d3s1gn0va/CapstonePy/01_Project_Context.md

# 01 Project Context

> 이전 3채널 시점의 맥락 기록이다. 최신 소스와 6축/BLE/눈 구성은 [CURRENT_SOURCE.md](CURRENT_SOURCE.md), 각도/운용 상태는 `docs/09_CURRENT_STATE.md`와 `docs/08_CALIBRATION_AND_SAFETY.md`를 우선한다.

## 1. 프로젝트 한 줄 요약

Raspberry Pi 4, Arduino Mega 2560, PCA9685, 서보모터를 사용해 아이와 자연스럽게 상호작용하는 가정용 로봇 경험을 전시용 워킹 프로토타입으로 구현하는 산업디자인 캡스톤디자인 프로젝트다.

## 2. 프로젝트 개요

* 프로젝트명 또는 임시 이름: Capstone Robot Project, capstone-robot-project
* 핵심 주제: 아이의 일상 속 자연스러운 상호작용을 유도하는 가정용 상호작용 로봇
* 해결하려는 문제: 아이의 사회적 의사소통 행동을 반복적으로 관찰할 수 있는 자연스러운 상호작용 경험이 필요함
* 목표: 1차 심사용 워킹 프로토타입을 안정적으로 전시/시연할 수 있게 만드는 것
* 대상 사용자 또는 대상 상황: 아이가 있는 가정 환경, 전시/심사 현장에서의 시연 상황
* 최종적으로 만들고자 하는 것: 버튼 입력을 받아 고개, 팔, 카메라 서보, 음성, LED가 정해진 시퀀스로 작동하는 로봇 프로토타입

## 3. 프로젝트가 시작된 배경

이 프로젝트는 산업디자인 캡스톤디자인 프로젝트로 시작되었다. 사용자가 정리한 핵심 맥락은 “아이의 일상 속 자연스러운 상호작용을 유도하고, 사회적 의사소통 행동을 반복적으로 관찰할 수 있는 가정용 상호작용 로봇 경험”이다.

초기에는 Raspberry Pi, Arduino Mega 2560, PCA9685를 사용하는 로봇 기준 저장소를 만들고, Raspberry Pi 코드와 Arduino 코드를 안전하게 원격 개발/배포할 수 있는 구조를 갖추는 것이 주요 과제였다. 이후 전시 버튼 시퀀스, 고개/팔 서보 각도 조정, 카메라 서보 추가, 전원 OFF 버튼, 카메라 동작 LED까지 기능이 확장되었다.

## 4. 현재까지 진행된 흐름

### 저장소 기준 구조 생성

* 당시 다룬 내용: Raspberry Pi 코드, Arduino 코드, scripts, systemd, docs 구조를 생성함
* 새롭게 정리된 점: 이 저장소를 “단일 기준 저장소”로 사용하기로 함
* 방향이 바뀌었다면 바뀐 이유: 없음
* 그 단계 이후 남은 과제: 실제 Raspberry Pi 코드와 Arduino 코드를 가져와 자리표시자 파일을 교체해야 했음

### Raspberry Pi 실제 코드 가져오기

* 당시 다룬 내용: Mac 프로젝트 폴더로 Raspberry Pi의 `~/robot_demo`를 `rsync`로 가져옴
* 새롭게 정리된 점: Python 파일, WAV 파일 2개, Arduino ino 파일, 배포/상태/로그 스크립트가 기준 저장소에 정리됨
* 방향이 바뀌었다면 바뀐 이유: 빈 자리표시자 파일에서 실제 작동 코드 중심으로 전환됨
* 그 단계 이후 남은 과제: Python 검사, 민감정보 제외, 원격 배포/Arduino 빌드 자동화가 필요했음

### 원격 개발 자동화 정리

* 당시 다룬 내용: `deploy_pi.sh`, `status_robot.sh`, `logs_robot.sh`, `build_arduino_remote.sh`, `flash_arduino_remote.sh` 등을 정리함
* 새롭게 정리된 점: Raspberry Pi SSH 주소는 `hyunwoo@192.168.0.39`, SSH 키는 `~/.ssh/robotpi_ed25519`를 사용함
* 방향이 바뀌었다면 바뀐 이유: 집에서 Mac으로 개발하고 Pi/Arduino에 원격 배포하는 구조가 필요했음
* 그 단계 이후 남은 과제: Arduino 업로드는 반드시 사용자가 `Arduino 업로드 승인`이라고 명시한 뒤 진행해야 함

### 전시 시퀀스 고개/팔 조정

* 당시 다룬 내용: 기본 고개 위치와 목표 각도, 팔 각도, 이동 시간을 여러 차례 조정함
* 새롭게 정리된 점: 현재 전시 버튼 시퀀스는 고개 `0 -> 70 -> 0`, 팔 `90 -> 180 -> 90` 흐름이며, 고개와 팔의 상승 이동은 동시에 시작함
* 방향이 바뀌었다면 바뀐 이유: 처음에는 고개가 먼저 다 돌아간 뒤 팔이 움직였지만, 사용자가 “고개 돌아갈때 팔도 같이 움직이게” 바꾸길 원했음
* 그 단계 이후 남은 과제: 팔 180도 사용은 기구물 충돌 가능성이 있으므로 실제 작동 시 계속 확인해야 함

### 카메라 서보 추가

* 당시 다룬 내용: PCA9685 Channel 2에 카메라 좌우 회전 서보를 추가함
* 새롭게 정리된 점: 카메라 버튼을 누르면 카메라 서보가 `90 -> 30 -> 150 -> 90`으로 움직임
* 방향이 바뀌었다면 바뀐 이유: 사용자가 “3번핀에 서보를 추가했는데, 이게 뭐냐면 카메라를 좌 우로 돌리는 서보모터”라고 설명함
* 그 단계 이후 남은 과제: 카메라 서보 모델명, 실제 장착 방향, 케이블 걸림 여부는 [확인 필요]

### 버튼 3개 구조 추가

* 당시 다룬 내용: 기존 전시 버튼 외에 전원 OFF 버튼, 카메라 움직임 버튼을 추가함
* 새롭게 정리된 점: 전시 버튼은 GPIO17, 전원 OFF 버튼은 GPIO27, 카메라 버튼은 GPIO22를 사용함
* 방향이 바뀌었다면 바뀐 이유: 사용자가 “스위치를 두개를 더 만들고싶어”라고 요청함
* 그 단계 이후 남은 과제: 전원 OFF 버튼은 sudoers 설정이 필요함. `scripts/setup_pi_shutdown_permission.sh`를 실행해야 함

### 카메라 LED 추가

* 당시 다룬 내용: 카메라 버튼을 눌러 카메라 서보가 회전하는 동안 3V 규격 LED 한 개를 켜는 기능을 추가함
* 새롭게 정리된 점: 카메라 LED는 Raspberry Pi GPIO23, 물리 핀 16번을 사용함
* 방향이 바뀌었다면 바뀐 이유: 사용자가 “카메라 버튼을 눌렀을때 카메라 서보가 회전하는 동안 약 3V전압 규격의 LED 한개를 켜져있게” 하고 싶다고 요청함
* 그 단계 이후 남은 과제: LED 배선에는 220Ω 또는 330Ω 직렬 저항이 필요함. 실제 밝기와 방향은 [확인 필요]

## 5. 현재 확정된 방향

* 문제정의: 아이가 자연스럽게 반응할 수 있는 로봇 상호작용을 만들고, 그 과정에서 사회적 의사소통 행동을 관찰할 수 있게 한다
* 타깃 사용자: 아이와 보호자가 있는 가정 환경, 그리고 1차 심사용 전시 상황
* 컨셉 방향: 버튼 입력 하나로 짧고 반복 가능한 상호작용 시퀀스를 수행하는 가정용 상호작용 로봇
* 핵심 기능 또는 구성:
  * 전시 버튼: 고개 회전, 팔 상승, WAV 음성 2개 재생, 초기 자세 복귀
  * 카메라 버튼: 카메라 서보 좌우 회전과 LED 점등
  * 전원 OFF 버튼: Raspberry Pi 안전 종료 요청
  * Raspberry Pi: 버튼 입력, 오디오 재생, 시퀀스 타임라인 제어
  * Arduino Mega: USB Serial 명령 수신, PCA9685를 통한 서보 제어
  * PCA9685: 고개, 오른팔, 카메라 서보 PWM 제어
* 발표/보고서에서 유지해야 할 논리: 기술 자체보다 “아이의 자연스러운 상호작용 경험”과 “반복 관찰 가능한 전시/가정용 프로토타입” 논리를 유지해야 함
* 제작 또는 구현 방향: Mac에서 코드 수정, Raspberry Pi로 rsync 배포, Arduino는 Pi에서 arduino-cli로 원격 컴파일/업로드

## 6. 현재 프로젝트 상태

* 이미 정리된 것:
  * 저장소 구조와 문서 구조
  * Raspberry Pi 실제 코드
  * Arduino Mega + PCA9685 펌웨어
  * WAV 파일 2개: `01_name_call.wav`, `02_lets_play.wav`
  * 원격 배포/상태/로그/Arduino 빌드/업로드 스크립트
  * 3버튼, 3서보, 카메라 LED 구조
* 아직 부족한 것:
  * 실제 로봇 외형, 기구 구조, 치수, 재료, 마감 정보
  * 실제 배선 사진과 전원 분배 구조
  * 카메라 서보 모델명과 장착 방향
  * 카메라 30..150도, 팔 180도 범위의 장기 안전성 확인
  * 전원 OFF 버튼 sudoers 설정 완료 여부 [확인 필요]
  * 전시 자동 실행 방식의 현장 검증 결과 [확인 필요]
* 현재 가장 중요한 문제:
  * 넓어진 서보 범위에서 기구물 충돌, 케이블 걸림, 전원 부족 문제가 없는지 실제 장치에서 확인해야 함
* 다음에 바로 해야 할 일:
  * 카메라 LED를 GPIO23에 저항 포함 배선
  * 카메라 버튼을 눌러 LED ON/OFF와 카메라 서보 동작 확인
  * 전시 버튼을 눌러 고개/팔 동시 이동과 WAV 재생 확인
  * 전원 OFF 버튼이 실제로 Pi를 안전 종료하는지 확인

## 7. 다른 GPT가 이어받을 때 꼭 알아야 할 것

* 사용자는 이 저장소를 “단일 기준 저장소”로 쓰고 싶어 한다.
* 사용자가 중요하게 말한 버튼 이름은 “전시버튼”, “카메라 버튼”, “전원off 버튼”이다.
* Arduino 업로드는 반드시 사용자가 `Arduino 업로드 승인`이라고 명시해야 진행한다.
* `SERVO_MIN_PULSE_US = 1000`, `SERVO_MAX_PULSE_US = 2000`은 별도 승인 없이 바꾸면 안 된다.
* 현재 서보 범위는 넓다. 팔 180도, 카메라 30..150도는 충돌/케이블 걸림 위험이 있다.
* Raspberry Pi 프로그램 시작 시 기본 자세 이동 명령이 나간다. 현재 부팅/시작 시 고개 `0도`, 팔 `90도`로 `1800ms` 이동한다.
* Arduino는 실제 서보 위치를 센서로 읽지 않는다. 부팅 직후 내부 현재값은 실제 물리 위치와 다를 수 있다.
* 오디오는 `pw-play`를 우선 사용한다.
* 공개 저장소에 SSH 키, 비밀번호, 토큰, `.env`, `scripts/local.env`, 로그 파일을 포함하면 안 된다.
* 실제 Raspberry Pi 상태와 저장소 문서 상태가 어긋날 수 있다. 작업 전 `config.py`, `main.py`, `servo_controller.ino`, 최근 로그를 확인하는 것이 좋다.

## 8. 다음 작업 제안

1. 카메라 LED 배선 후 카메라 버튼 테스트
   * GPIO23, 물리 핀 16번
   * GPIO23 -> 220Ω 또는 330Ω 저항 -> LED 긴 다리 -> LED 짧은 다리 -> GND
2. 팔 180도와 카메라 30..150도 범위의 물리 간섭 확인
   * 서보 혼, 외장, 케이블, 전원 공급 상태를 함께 확인
3. 전원 OFF 버튼 sudoers 설정 확인
   * `bash scripts/setup_pi_shutdown_permission.sh`
   * 성공 메시지: `Installed /etc/sudoers.d/010-robot-shutdown`
4. 전시 버튼 전체 시퀀스 확인
   * 고개/팔 동시 시작
   * `01_name_call.wav`, `02_lets_play.wav` 재생
   * 복귀 동작 확인
5. 배선 사진과 실제 핀맵을 `docs/assets/wiring/`에 추가
6. 로봇 외형/기구 구조 자료를 `docs/assets/robot_design/` 또는 `docs/assets/cad_exports/`에 추가
7. 문서 상태 갱신
   * `docs/09_CURRENT_STATE.md`가 실제 배포/업로드 상태와 맞는지 확인 필요
