d3s1gn0va/CapstonePy/02_Reasoning_and_Questions.md

# 02 Reasoning And Questions

> 이전 3채널 시점의 판단 기록이다. 최신 위임/범위/안전 기준은 `AGENTS.md`, `CURRENT_SOURCE.md`, `docs/09_CURRENT_STATE.md`를 우선한다.

## 1. 핵심 판단 흐름 요약

이 프로젝트는 처음에는 Raspberry Pi 4, Arduino Mega 2560, PCA9685를 사용하는 캡스톤디자인 로봇 프로젝트의 기준 저장소를 만드는 일에서 시작했다. 이후 Raspberry Pi 실제 코드와 Arduino 코드를 Mac 프로젝트로 가져오고, 원격 배포/컴파일/업로드 자동화 구조를 갖췄다.

기능은 처음의 “전시버튼을 누르면 고개와 팔, WAV 음성이 순서대로 실행되는 시퀀스”에서 출발했다. 이후 사용자가 고개 기본 각도와 목표 각도를 바꾸고, 서보 속도를 낮추고, 카메라 서보를 추가하고, 전원 OFF 버튼과 카메라 버튼을 추가하면서 3버튼/3서보 구조로 확장되었다.

현재 방향은 다음 판단에 의해 정리되었다.

* Raspberry Pi는 전체 타임라인과 버튼 입력, 오디오, LED를 담당한다.
* Arduino Mega는 PCA9685를 통해 서보만 안전 범위 안에서 움직인다.
* Arduino 업로드는 실제 하드웨어에 영향을 주므로 사용자가 `Arduino 업로드 승인`이라고 명시한 경우에만 진행한다.
* 전시 시퀀스는 사용자가 원하는 감각에 맞춰 고개와 팔이 동시에 움직이도록 바뀌었다.
* 카메라 버튼은 다른 서보와 음성을 건드리지 않고 카메라 서보와 LED만 제어하는 독립 기능으로 정리되었다.

## 2. 주요 의견과 관점

### 기준 저장소가 필요하다

* 내용: 이 폴더를 Raspberry Pi, Arduino Mega 2560, PCA9685를 사용하는 로봇 프로젝트의 기준 저장소로 만들고자 했다.
* 왜 중요했는지: 새 GPT 대화를 시작해도 프로젝트 맥락과 코드 위치, 안전 규칙을 잃지 않게 하기 위해서다.
* 프로젝트 방향에 준 영향: `AGENTS.md`, `README.md`, `docs/` 문서 구조, 원격 배포 스크립트, 안전 규칙이 만들어졌다.
* 사용자 원문이 있다면 원문: “이 폴더는 Raspberry Pi 4, Arduino Mega 2560, PCA9685를 사용하는 캡스톤디자인 로봇 프로젝트의 기준 저장소야.”

### GitHub 공개 저장소 안전이 중요하다

* 내용: SSH 개인키, 비밀번호, 토큰, `.env`, 로그 파일은 Git에 포함하지 않아야 한다.
* 왜 중요했는지: 저장소가 Public 상태로 유지될 예정이었기 때문이다.
* 프로젝트 방향에 준 영향: `.gitignore`가 보강되었고, 배포/업로드 작업 전 민감정보 검사가 반복되었다.
* 사용자 원문이 있다면 원문: “GitHub 저장소는 Public 상태로 유지할 예정이다.”

### 전시 기능과 개발 시험 기능은 구분해야 한다

* 내용: 고개 0도에서 180도 이동 같은 기능은 개발 시험 항목으로 취급되었고, 최종 전시 동작과 구분되었다.
* 왜 중요했는지: 큰 각도 이동은 기구물 충돌과 서보 과부하 위험이 있기 때문이다.
* 프로젝트 방향에 준 영향: 위험 기능에는 명시적 확인 옵션이나 사용자 승인이 필요하다는 원칙이 생겼다.
* 사용자 원문이 있다면 원문: “고개 0도에서 180도 이동 요청은 현재 개발 시험 항목이며 최종 전시 동작으로 확정된 것이 아니다.”

### 사용자는 실제 하드웨어 배선 설명도 필요했다

* 내용: GPIO 번호뿐 아니라 브레드보드와 푸쉬스위치를 어디에 꽂아야 하는지 설명이 필요했다.
* 왜 중요했는지: 사용자가 “잘 몰라서”라고 말했기 때문에, 코드 변경만으로는 작업이 완성되지 않았다.
* 프로젝트 방향에 준 영향: 버튼 3개, 서보 3개, LED 배선 문서가 만들어졌다.
* 사용자 원문이 있다면 원문: “핀을 어디에서 어디로 꽂아야하는지 전부 알려줘 내가 잘 몰라서. 브레드보드랑 푸쉬스위치 연결까지 다 설명해줘.”

### 전원 OFF 버튼은 편의 기능이지만 sudoers 설정이 필요하다

* 내용: 터미널에 접속해서 끄는 대신 푸쉬스위치 한 번으로 Raspberry Pi를 끄고 싶어 했다.
* 왜 중요했는지: 전시/철수 상황에서 터미널 없이 안전 종료할 수 있어야 하기 때문이다.
* 프로젝트 방향에 준 영향: GPIO27 전원 OFF 버튼, `sudo shutdown -h now`, `setup_pi_shutdown_permission.sh`가 추가되었다.
* 사용자 원문이 있다면 원문: “이 스위치를 누르면 라즈베리파이가 꺼질수 있게 하는거야. 원래는 터미널 들어가서 해야했는데 그냥 푸쉬 스위치 한번만 누르면 끌수있게 해줘.”

### 카메라 서보는 독립 동작이어야 한다

* 내용: 카메라 버튼을 눌렀을 때 다른 서보는 가만히 있고 카메라만 천천히 좌우로 움직이길 원했다.
* 왜 중요했는지: 카메라 동작은 전시 시퀀스와 별도의 관찰/표현 기능으로 분리되어야 했기 때문이다.
* 프로젝트 방향에 준 영향: PCA9685 Channel 2, `MOVE_CAMERA`, GPIO22 카메라 버튼, 카메라 LED가 추가되었다.
* 사용자 원문이 있다면 원문: “다른거는 가만히 있고 카메라만 천천히 좌우로 움직이게 해줘.”

## 3. 주요 의문점과 고민

### 전원 켜고 시작할 때 서보가 무조건 기본 각도로 이동하는가?

* 내용: 사용자는 “전원 켜고 시작할 때”가 실제로 부팅 시 기본 자세 이동을 의미하는지 물었다.
* 왜 중요했는지: 전원을 켜자마자 서보가 움직이는 것은 전시 안전과 사용자 경험에 영향을 준다.
* 당시 고려한 답변 또는 방향: 현재 방식은 프로그램 시작 시 `MOVE_BOTH,0,90,1800` 명령을 보내 기본 자세로 이동하는 것이다. Arduino는 실제 서보 위치를 읽지 못하므로, 이미 그 각도에 있더라도 내부 상태 기준으로 움직일 수 있다.
* 현재 상태:
  * 해결됨

### 부팅 시 초기 자세 이동을 안 하는 방식이 가능한가?

* 내용: 부팅 시 초기 자세 이동 안 하기가 “매번 부팅시의 위치를 0도로 설정”하는 의미인지 질문했다.
* 왜 중요했는지: 사용자는 전원 투입 직후 움직임 여부를 이해하고 선택해야 했다.
* 당시 고려한 답변 또는 방향: “초기 자세 이동 안 하기”는 실제 서보를 0도로 맞추는 것이 아니라, 부팅 직후 아무 이동 명령도 보내지 않는 것이다. 그러나 사용자는 현재 방식을 유지하기로 했다.
* 현재 상태:
  * 보류

### 전시 버튼에서 팔이 언제 움직여야 하는가?

* 내용: 초기에는 고개가 다 돌아간 뒤 팔이 움직였지만, 사용자는 고개가 돌아가기 시작할 때 팔도 같이 움직이길 원했다.
* 왜 중요했는지: 전시 시퀀스의 인상과 타이밍이 달라지는 핵심 연출 요소다.
* 당시 고려한 답변 또는 방향: 고개 1200ms, 팔 900ms처럼 서로 다른 시간으로 동시에 시작하려면 새 Arduino 명령이 필요하다고 판단했다. 이후 사용자가 “그냥 팔도 1200ms으로 해”라고 했고, 기존 `MOVE_BOTH` 명령을 유지하는 방향으로 정리되었다.
* 현재 상태:
  * 해결됨

### 카메라 버튼과 전원 OFF 버튼이 먹통인 이유는 무엇이었나?

* 내용: 사용자는 전시버튼 외에는 아예 먹통이라고 느꼈다.
* 왜 중요했는지: 새로 추가한 GPIO 배선, Python 이벤트 처리, Arduino 펌웨어 업로드 여부를 구분해야 했다.
* 당시 고려한 답변 또는 방향: GPIO 감시 결과 GPIO22와 GPIO27은 누를 때 `hi -> lo`로 정상 변화했다. 전원 OFF는 sudoers 권한 문제였고, 카메라는 Arduino에 `MOVE_CAMERA` 펌웨어 업로드가 필요했다.
* 현재 상태:
  * 부분 해결

### 카메라 동작 중 LED를 켤 수 있는가?

* 내용: 사용자는 카메라 서보가 움직이는 동안 약 3V 전압 규격 LED 한 개를 켜고 싶어 했다.
* 왜 중요했는지: 카메라 동작 상태를 물리적으로 보여주는 피드백 기능이다.
* 당시 고려한 답변 또는 방향: Arduino가 아니라 Raspberry Pi GPIO23으로 LED를 제어하는 것이 가장 단순하고 적절하다고 판단했다. `run_camera_sequence()` 전후로 LED ON/OFF를 넣었다.
* 현재 상태:
  * 해결됨

## 4. 의사결정과 근거

### Raspberry Pi와 Arduino 역할 분리

* 결정한 내용: Raspberry Pi는 버튼/오디오/타임라인/LED, Arduino는 서보 PWM 제어를 담당한다.
* 고려했던 선택지: Arduino에서 더 많은 타임라인을 처리하는 방식도 가능했지만, 현재 코드와 요구는 Raspberry Pi 중심 타임라인에 맞았다.
* 선택한 이유: WAV 재생과 버튼 시퀀스, 원격 개발은 Raspberry Pi에서 다루기 쉽다.
* 근거: `main.py`가 전체 시퀀스를 제어하고, `servo_controller.ino`는 Serial 명령을 받아 PCA9685로 서보를 움직인다.
* 남은 불확실성: 최종 전시 자동 실행 방식의 현장 검증 결과는 [확인 필요]

### Arduino 업로드는 명시 승인 후에만 진행

* 결정한 내용: 사용자가 `Arduino 업로드 승인`이라고 정확히 말한 경우에만 Arduino 업로드를 진행한다.
* 고려했던 선택지: 컴파일 후 자동 업로드, 또는 업로드 직전 일반 확인
* 선택한 이유: Arduino 업로드는 보드 리셋과 서보 움직임을 유발할 수 있다.
* 근거: `AGENTS.md` 안전 규칙과 대화 중 반복된 사용자 승인 절차
* 남은 불확실성: 없음

### 카메라 버튼은 독립 시퀀스로 처리

* 결정한 내용: 카메라 버튼은 고개/팔/오디오와 무관하게 카메라 서보만 `90 -> 30 -> 150 -> 90`으로 움직인다.
* 고려했던 선택지: 전시 시퀀스 안에 카메라 움직임을 포함하는 방식
* 선택한 이유: 사용자가 “다른거는 가만히 있고 카메라만”이라고 요청했다.
* 근거: `main.py`의 `run_camera_sequence()`와 `serial_controller.py`의 `move_camera()`
* 남은 불확실성: 카메라 서보 모델명, 실제 장착 방향, 케이블 간섭 여부는 [확인 필요]

### LED는 Arduino가 아니라 Raspberry Pi GPIO로 제어

* 결정한 내용: 카메라 LED는 GPIO23으로 연결하고 Python에서 켜고 끈다.
* 고려했던 선택지: Arduino/PCA9685 쪽에서 LED 제어
* 선택한 이유: 카메라 버튼과 카메라 시퀀스 타이밍을 Raspberry Pi가 이미 알고 있어 Python에서 처리하는 것이 단순하다.
* 근거: `gpiozero.LED`, `CAMERA_LED_GPIO = 23`, `finally`로 LED OFF 보장
* 남은 불확실성: LED 실제 배선 방향, 저항값, 밝기는 [확인 필요]

### 팔과 고개 동시 이동은 기존 `MOVE_BOTH` 사용

* 결정한 내용: 고개와 팔을 동시에 1200ms 동안 움직이게 하고, 별도 Arduino 명령은 만들지 않는다.
* 고려했던 선택지: 고개 1200ms, 팔 900ms를 위해 새 `MOVE_BOTH_TIMED` 명령 추가
* 선택한 이유: 사용자가 “그냥 팔도 1200ms으로 해”라고 방향을 바꿨다.
* 근거: 기존 `MOVE_BOTH,<head>,<arm>,<duration>` 명령으로 충분해짐
* 남은 불확실성: 팔 180도에서 기구물 충돌이 없는지 [확인 필요]

## 5. 방향이 바뀐 지점

### 고개 전체 범위 이동에서 더 작은 전시 각도로 변경

* 이전 방향: 고개 `0 -> 180 -> 0` 흐름을 사용한 이력이 있다.
* 바뀐 방향: 현재 전시 버튼은 고개 `0 -> 70 -> 0`이다.
* 바뀐 이유: 사용자가 전시 시퀀스의 회전량을 조정하고 싶어 했다.
* 이 변화가 프로젝트에 준 영향: 고개 전체 범위 테스트는 개발 시험 성격으로 남고, 전시 시퀀스는 더 제한된 각도 이동이 되었다.

### 팔 움직임 순서 변경

* 이전 방향: 고개가 먼저 돌아간 뒤 팔이 움직였다.
* 바뀐 방향: 고개와 팔이 동시에 움직인다.
* 바뀐 이유: 사용자가 “고개가 돌아가기 시작할때, 팔의 움직임도 동시에 시작”하길 원했다.
* 이 변화가 프로젝트에 준 영향: 전시 시퀀스의 첫 동작이 더 통합된 제스처가 되었고, `MOVE_BOTH` 명령이 핵심이 되었다.

### 카메라 기능 추가

* 이전 방향: 고개와 오른팔 2서보 중심 구조였다.
* 바뀐 방향: 고개, 오른팔, 카메라 3서보 구조가 되었다.
* 바뀐 이유: 사용자가 카메라를 좌우로 돌리는 새 서보를 추가했다.
* 이 변화가 프로젝트에 준 영향: Arduino 안전 범위, Serial 명령, Python 버튼 처리, 배선 문서가 모두 확장되었다.

### 카메라 LED 피드백 추가

* 이전 방향: 카메라 버튼은 서보만 움직였다.
* 바뀐 방향: 카메라 서보가 움직이는 동안 GPIO23 LED가 켜진다.
* 바뀐 이유: 사용자가 카메라 동작 중 LED가 켜져 있기를 원했다.
* 이 변화가 프로젝트에 준 영향: Raspberry Pi GPIO 출력이 추가되었고, LED 배선 안전 규칙이 추가되었다.

## 6. 폐기되었거나 보류된 아이디어

### `MOVE_BOTH_TIMED` 같은 새 Arduino 명령

* 내용: 고개 1200ms, 팔 900ms처럼 서로 다른 시간으로 동시에 시작하려면 새 Serial 명령을 추가하는 방향을 검토했다.
* 왜 고려했는지: 기존 `MOVE_BOTH`는 고개와 팔에 같은 duration만 줄 수 있기 때문이다.
* 왜 폐기 또는 보류했는지: 사용자가 팔도 1200ms로 맞추겠다고 해서 필요 없어졌다.
* 다시 검토할 가능성이 있는지: 나중에 고개와 팔의 동시 시작은 유지하되 서로 다른 이동 시간이 필요해지면 다시 검토 가능하다.

### 부팅 시 초기 자세 이동 안 하기

* 내용: 프로그램 시작 시 기본 자세 이동 명령을 보내지 않는 방식
* 왜 고려했는지: 부팅 직후 서보 움직임이 발생하는 것을 피할 수 있기 때문이다.
* 왜 폐기 또는 보류했는지: 사용자가 “지금 상태 그대로 놔둬. 지금이 1번인거 맞지?”라고 하며 현재 방식을 유지했다.
* 다시 검토할 가능성이 있는지: 전원 투입 직후 움직임이 전시 안전에 문제가 되면 다시 검토 가능하다.

### Arduino가 아니라 Raspberry Pi에서 카메라 서보 직접 제어

* 내용: 카메라 서보를 Raspberry Pi GPIO/PWM으로 직접 제어하는 방식
* 왜 고려했는지: [확인 필요] 실제 대화에서 명시적으로 깊게 검토되지는 않았다.
* 왜 폐기 또는 보류했는지: 현재 구조가 Arduino + PCA9685 서보 제어로 일관되어 있고, 카메라 서보도 PCA9685 Channel 2에 추가하는 것이 자연스러웠다.
* 다시 검토할 가능성이 있는지: 현재는 낮다.

## 7. 아직 열려 있는 질문

* 질문: 전원 OFF 버튼 sudoers 설정이 실제로 완료되었는가?
* 왜 중요한지: 설정이 안 되어 있으면 버튼 입력은 들어와도 `sudo: 암호가 필요합니다`로 종료가 실패한다.
* 해결하려면 필요한 것: Raspberry Pi에서 `scripts/setup_pi_shutdown_permission.sh` 실행 결과 확인
* 우선순위: 높음

* 질문: 팔 180도 동작이 실제 기구물에 안전한가?
* 왜 중요한지: 팔 서보가 큰 각도로 움직이며 외장이나 다른 부품에 부딪힐 수 있다.
* 해결하려면 필요한 것: 실제 로봇에서 느린 속도 테스트, 충돌/과부하 확인
* 우선순위: 높음

* 질문: 카메라 30..150도 범위에서 케이블이 걸리지 않는가?
* 왜 중요한지: 카메라 케이블이 고개, 팔, 외장 구조물에 걸릴 수 있다.
* 해결하려면 필요한 것: 실제 배선 상태에서 반복 테스트
* 우선순위: 높음

* 질문: 카메라 LED 배선이 올바른가?
* 왜 중요한지: 저항 없이 연결하면 LED나 Raspberry Pi GPIO가 손상될 수 있다.
* 해결하려면 필요한 것: 220Ω 또는 330Ω 직렬 저항, LED 방향 확인
* 우선순위: 높음

* 질문: 최종 전시 자동 실행 방식은 현장에서 검증되었는가?
* 왜 중요한지: 전시에서는 네트워크 없이 전원 투입 후 자동으로 버튼 대기 상태가 되어야 한다.
* 해결하려면 필요한 것: 실제 Raspberry Pi 부팅 테스트와 로그 확인
* 우선순위: 중간

* 질문: 로봇 외형과 기구 구조, 전원 분배 구조는 문서화되었는가?
* 왜 중요한지: 다른 사람이 하드웨어를 이해하고 재현하려면 사진과 핀맵이 필요하다.
* 해결하려면 필요한 것: 배선 사진, CAD/스케치, 전원 공급 정보
* 우선순위: 중간

## 8. 다른 GPT가 반복하지 말아야 할 것

* Arduino 업로드를 사용자 승인 없이 진행하자고 제안하지 말 것.
* `SERVO_MIN_PULSE_US`, `SERVO_MAX_PULSE_US`를 임의로 바꾸지 말 것.
* 카메라 LED를 저항 없이 GPIO에 직접 연결하라고 안내하지 말 것.
* “부팅 시 초기 자세 이동 안 하기”를 현재 요구로 오해하지 말 것. 사용자는 현재 부팅 시 기본 자세 이동 방식을 유지하기로 했다.
* 카메라 버튼을 전시 시퀀스와 섞어 설명하지 말 것. 현재 카메라 버튼은 독립 동작이다.
* GPIO 번호와 물리 핀 번호를 혼동하지 말 것. 현재 문서는 BCM 번호 기준으로 코드가 작성되어 있다.
* 공개 저장소에 SSH 키, 비밀번호, 토큰, `.env`, 로그 파일을 포함하지 말 것.

## 9. 다른 GPT에게 전달할 핵심 메모

* 이 프로젝트는 “예쁜 요약”보다 실제 이어받기 가능한 작업 맥락이 중요하다.
* 사용자는 실제 하드웨어를 만지면서 진행하고 있으므로, 코드 변경뿐 아니라 배선, 전원, 충돌 위험을 함께 설명해야 한다.
* Raspberry Pi 쪽 변경은 Python 검사 후 배포하고, 배포 후 상태와 로그를 확인한다.
* Arduino 쪽 변경은 컴파일까지만 자동으로 가능하고, 업로드는 `Arduino 업로드 승인`이 필요하다.
* 현재 전시 버튼 시퀀스는 고개 `0 -> 70 -> 0`, 팔 `90 -> 180 -> 90`, 고개/팔 상승 동시 시작이다.
* 현재 카메라 버튼 시퀀스는 카메라 `90 -> 30 -> 150 -> 90`이며, 동작 중 GPIO23 LED가 켜진다.
* 전원 OFF 버튼은 GPIO27이고, 실제 종료에는 sudoers 설정이 필요하다.
* 문서와 실제 Raspberry Pi 상태가 어긋날 수 있으므로, 중요한 작업 전에는 로컬 코드와 Pi의 배포 상태를 모두 확인하는 것이 좋다.
