d3s1gn0va/CapstonePy/03_Current_Output.md

# 03 Current Output

> 이전 3채널 시점의 산출물 기록이다. 현재 소스 목록과 6축/BLE/눈 구성은 [CURRENT_SOURCE.md](CURRENT_SOURCE.md)를 우선한다.

## 1. 현재까지 만들어진 산출물 요약

현재까지 작성되었거나 정리된 산출물은 다음과 같다.

* 프로젝트 기준 저장소 구조
* `README.md`, `AGENTS.md`, `PLANS.md`
* 프로젝트 맥락 문서: `docs/00_PROJECT_BRIEF.md`부터 `docs/12_BUTTON_AND_SERVO_WIRING.md`
* 인수인계 문서:
  * `01_Project_Context.md`
  * `02_Reasoning_and_Questions.md`
* Raspberry Pi 실행 코드:
  * `main.py`
  * `config.py`
  * `serial_controller.py`
  * `audio_player.py`
* Arduino Mega + PCA9685 펌웨어:
  * `arduino/servo_controller/servo_controller.ino`
* 원격 개발 스크립트:
  * Raspberry Pi 배포, 상태 확인, 로그 확인
  * Arduino 원격 컴파일/업로드
  * Raspberry Pi shutdown 권한 설정
* 전시 기능:
  * 전시 버튼 시퀀스
  * 카메라 버튼 시퀀스
  * 전원 OFF 버튼
  * 카메라 동작 중 LED 점등
* 배선 설명:
  * 버튼 3개
  * 서보 3개
  * GPIO23 카메라 LED

## 2. 현재 컨셉 설명

* 컨셉명: [확인 필요]
* 한 줄 설명: 아이의 일상 속 자연스러운 상호작용을 유도하고, 사회적 의사소통 행동을 반복적으로 관찰할 수 있는 가정용 상호작용 로봇 경험
* 자세한 설명: Raspberry Pi와 Arduino Mega, PCA9685, 서보모터를 활용해 버튼 입력에 반응하는 로봇 워킹 프로토타입이다. 전시 버튼을 누르면 고개와 팔이 움직이고 WAV 음성이 재생된다. 별도 카메라 버튼을 누르면 카메라 서보가 좌우로 움직이며 LED가 켜진다. 전원 OFF 버튼은 Raspberry Pi 안전 종료를 요청한다.
* 해결하려는 문제: 아이가 자연스럽게 반응할 수 있는 상호작용 상황을 만들고, 그 과정에서 사회적 의사소통 행동을 반복적으로 관찰할 수 있게 하는 것
* 대상 사용자: 아이와 보호자가 있는 가정 환경, 1차 심사용 전시 상황
* 핵심 가치: 자연스러운 상호작용, 반복 가능한 시연, 관찰 가능한 행동, 하드웨어 기반 워킹 프로토타입
* 차별점: 단순한 화면 기반 인터랙션이 아니라 고개, 팔, 카메라, 음성, LED가 함께 작동하는 물리 로봇 경험이라는 점

## 3. 문제정의 문장

### 현재 가장 유력한 문장

* 문장: 아이의 일상 속 자연스러운 상호작용을 유도하고, 사회적 의사소통 행동을 반복적으로 관찰할 수 있는 가정용 상호작용 로봇 경험을 제안한다.
* 출처 구분: 사용자 제공 맥락을 바탕으로 저장소 문서에 정리된 문장
* 사용 가능 여부: 사용 가능
* 수정 필요 여부: 발표용으로는 더 짧게 다듬을 수 있음

### 이전에 사용했던 문장

* 문장: 이 프로젝트는 아이의 일상 속 자연스러운 상호작용을 유도하고, 사회적 의사소통 행동을 반복적으로 관찰할 수 있는 가정용 상호작용 로봇 경험을 제안합니다.
* 출처 구분: GPT가 `README.md`에 정리한 문장
* 사용 가능 여부: 사용 가능
* 수정 필요 여부: 문체를 보고서체로 통일할지 확인 필요

* 문장: 로봇은 아이가 일상 속에서 자연스럽게 반응할 수 있는 짧은 상호작용 경험을 제공한다.
* 출처 구분: GPT가 `docs/01_PRODUCT_CONCEPT.md`에 정리한 문장
* 사용 가능 여부: 사용 가능
* 수정 필요 여부: 문제정의보다는 컨셉 설명에 더 적합함

### 수정이 필요한 문장

* 문장: 목표는 화려한 복잡 기능보다 반복 가능한 시연 흐름을 통해 사회적 의사소통 행동을 관찰할 수 있는 상황을 만드는 것이다.
* 출처 구분: GPT가 `docs/01_PRODUCT_CONCEPT.md`에 정리한 문장
* 사용 가능 여부: 사용 가능
* 수정 필요 여부: “화려한 복잡 기능보다”는 발표 문장으로는 다소 구어적일 수 있어 표현 다듬기 필요

### 폐기된 문장

* 문장: [확인 필요]
* 출처 구분: 현재 대화와 저장소 문서에서 명확히 폐기된 문제정의 문장은 확인되지 않음
* 사용 가능 여부: 확인 필요
* 수정 필요 여부: 확인 필요

## 4. 사용자 시나리오 또는 사용 흐름

### 전시 시연 흐름

출처 구분: GPT가 저장소 문서와 코드 기준으로 정리한 흐름

1. 전시자가 전원을 연결한다.
2. Raspberry Pi가 부팅된다.
3. 로봇 프로그램이 실행되고 버튼 입력을 기다린다.
4. 전시 버튼을 누른다.
5. 고개와 오른팔이 동시에 움직이기 시작한다.
6. `01_name_call.wav`가 재생된다.
7. `02_lets_play.wav`가 재생된다.
8. 짧게 유지한다.
9. 고개와 오른팔이 초기 자세로 복귀한다.
10. 다음 버튼 입력을 기다린다.

현재 코드 기준 전시 버튼 동작:

```text
고개: 0 -> 70 -> 0
팔: 90 -> 180 -> 90
고개/팔 상승 이동 시간: 1200ms
복귀 시간: 1800ms
```

### 카메라 버튼 흐름

출처 구분: GPT가 코드 기준으로 정리한 흐름

1. 카메라 버튼을 누른다.
2. GPIO23 LED가 켜진다.
3. 카메라 서보가 `90 -> 30 -> 150 -> 90`으로 이동한다.
4. 카메라 서보 동작이 끝나면 LED가 꺼진다.
5. 다음 버튼 입력을 기다린다.

### 전원 OFF 버튼 흐름

출처 구분: GPT가 코드 기준으로 정리한 흐름

1. 전원 OFF 버튼을 누른다.
2. Raspberry Pi에서 `sudo shutdown -h now`를 실행한다.
3. Raspberry Pi가 안전 종료된다.

주의: 이 흐름은 `scripts/setup_pi_shutdown_permission.sh`로 sudoers 설정이 완료되어야 정상 작동한다. 완료 여부는 [확인 필요].

## 5. 기능 또는 구성 요소

* 기능/요소: 전시 버튼
* 설명: GPIO17, 물리 핀 11번. 전시 시퀀스를 시작한다.
* 필요한 이유: 관람자 또는 전시자가 로봇 상호작용을 반복 실행하기 위해 필요하다.
* 현재 상태:
  * 확정

* 기능/요소: 전시 시퀀스
* 설명: 고개 `0 -> 70 -> 0`, 팔 `90 -> 180 -> 90`, WAV 파일 2개 재생, 초기 자세 복귀로 구성된다.
* 필요한 이유: 1차 심사용 워킹 프로토타입의 핵심 시연 흐름이다.
* 현재 상태:
  * 확정

* 기능/요소: 카메라 버튼
* 설명: GPIO22, 물리 핀 15번. 카메라 서보만 좌우로 움직인다.
* 필요한 이유: 카메라 움직임을 전시 시퀀스와 분리해 독립적으로 확인하기 위해 필요하다.
* 현재 상태:
  * 확정

* 기능/요소: 카메라 서보
* 설명: PCA9685 Channel 2. 현재 동작은 `90 -> 30 -> 150 -> 90`이다.
* 필요한 이유: 카메라를 좌우로 돌리는 물리 움직임을 만들기 위해 필요하다.
* 현재 상태:
  * 확정

* 기능/요소: 카메라 LED
* 설명: GPIO23, 물리 핀 16번. 카메라 서보가 움직이는 동안 켜진다.
* 필요한 이유: 카메라 동작 중임을 시각적으로 표시하기 위해 필요하다.
* 현재 상태:
  * 확정

* 기능/요소: 전원 OFF 버튼
* 설명: GPIO27, 물리 핀 13번. Raspberry Pi 안전 종료를 요청한다.
* 필요한 이유: 터미널 접속 없이 푸쉬스위치 한 번으로 Raspberry Pi를 끄기 위해 필요하다.
* 현재 상태:
  * 부분 확인 필요

* 기능/요소: Raspberry Pi
* 설명: 버튼 입력, WAV 재생, 전체 시퀀스 타임라인, GPIO23 LED 제어를 담당한다.
* 필요한 이유: 오디오와 로봇 시퀀스를 통합 제어하기 위해 필요하다.
* 현재 상태:
  * 확정

* 기능/요소: Arduino Mega 2560
* 설명: USB Serial 명령을 받아 PCA9685를 통해 서보를 움직인다.
* 필요한 이유: 서보 PWM 제어와 안전 범위 검사를 담당하기 위해 필요하다.
* 현재 상태:
  * 확정

* 기능/요소: PCA9685
* 설명: 고개, 오른팔, 카메라 서보를 제어하는 PWM 드라이버다.
* 필요한 이유: 여러 서보를 안정적으로 제어하기 위해 필요하다.
* 현재 상태:
  * 확정

* 기능/요소: WAV 음성
* 설명: `01_name_call.wav`, `02_lets_play.wav` 두 파일을 사용한다.
* 필요한 이유: 로봇이 아이에게 말을 거는 상호작용 경험을 만들기 위해 필요하다.
* 현재 상태:
  * 확정

* 기능/요소: 자동 실행
* 설명: 전원을 켜면 Raspberry Pi가 자동 부팅되고 프로그램이 실행되어 버튼 입력을 기다리는 구성이 목표다.
* 필요한 이유: 전시에서는 네트워크 없이 독립 작동해야 하기 때문이다.
* 현재 상태:
  * 확인 필요

## 6. 발표자료 또는 보고서 구성

현재 대화와 저장소 문서에서 확인되는 발표/보고서 흐름 초안은 다음 정도다.

1. 프로젝트 배경
   * 산업디자인 캡스톤디자인 프로젝트
   * 아이의 일상 속 자연스러운 상호작용
   * 사회적 의사소통 행동의 반복 관찰
2. 문제정의
   * 자연스럽게 반응할 수 있는 상호작용 상황의 필요
3. 컨셉
   * 가정용 상호작용 로봇 경험
   * 짧고 반복 가능한 물리 시연
4. 시스템 구성
   * Raspberry Pi
   * Arduino Mega 2560
   * PCA9685
   * 고개/팔/카메라 서보
   * WAV 음성
   * 버튼 3개와 LED
5. 전시 시연 흐름
   * 전원 연결
   * 자동 실행 및 버튼 대기
   * 전시 버튼 시퀀스
   * 카메라 버튼 시퀀스
   * 안전 종료
6. 현재 워킹 프로토타입 상태
   * 구현 완료 기능
   * 아직 확인 필요한 기구/배선/전원 요소
7. 다음 개발 과제
   * 실제 배선 사진과 핀맵
   * 기구 충돌 확인
   * 전시 자동 실행 검증
   * 외형/기구 자료 추가

주의: 발표자료의 시각 스타일, 슬라이드 수, 보고서 최종 목차는 [확인 필요].

## 7. 그대로 보존하면 좋은 문장

### 사용자 직접 표현

* 문장: “이 폴더는 Raspberry Pi 4, Arduino Mega 2560, PCA9685를 사용하는 캡스톤디자인 로봇 프로젝트의 기준 저장소야.”
* 사용 가능 위치: 개발 문서, 저장소 설명
* 왜 중요한지: 프로젝트의 기술 스택과 기준 저장소 성격을 명확히 말한다.
* 수정 필요 여부: 발표용보다는 개발 문서용으로 그대로 사용 가능

* 문장: “아이의 일상 속 자연스러운 상호작용을 유도하고, 사회적 의사소통 행동을 반복적으로 관찰할 수 있는 가정용 상호작용 로봇 경험을 제안한다.”
* 사용 가능 위치: 문제정의, 컨셉 설명, README, 발표 서두
* 왜 중요한지: 프로젝트의 핵심 목적을 가장 잘 담고 있다.
* 수정 필요 여부: 거의 없음. 발표 제목/카피로 쓰려면 더 짧게 다듬을 수 있음

* 문장: “전시에서는 네트워크 없이 독립 작동해야 한다.”
* 사용 가능 위치: 전시 요구사항, 시스템 설계 조건
* 왜 중요한지: 자동 실행과 로컬 하드웨어 제어가 필요한 이유를 설명한다.
* 수정 필요 여부: 없음

* 문장: “전원을 켜면 Raspberry Pi가 자동 부팅되고 프로그램이 실행되어 시연 버튼 입력을 기다려야 한다.”
* 사용 가능 위치: 전시 시나리오, 시스템 요구사항
* 왜 중요한지: 전시 운영 방식의 핵심 요구사항이다.
* 수정 필요 여부: 없음

* 문장: “시연 중 추가 버튼 입력은 무시한다.”
* 사용 가능 위치: 동작 규칙, UX 설명
* 왜 중요한지: 중복 입력으로 시퀀스가 꼬이지 않게 하는 기준이다.
* 수정 필요 여부: 없음

* 문장: “철수 시에는 Raspberry Pi 안전 종료 후 전체 전원을 끈다.”
* 사용 가능 위치: 운영 SOP, 안전 문서
* 왜 중요한지: 전원 OFF 버튼과 shutdown 기능의 필요를 설명한다.
* 수정 필요 여부: 없음

* 문장: “다른거는 가만히 있고 카메라만 천천히 좌우로 움직이게 해줘.”
* 사용 가능 위치: 기능 요구사항 원문 기록
* 왜 중요한지: 카메라 버튼이 전시 시퀀스와 독립이어야 한다는 사용자 의도를 직접 보여준다.
* 수정 필요 여부: 보고서 본문에는 다듬어 사용

* 문장: “고개 돌아갈때 팔도 같이 움직이게.”
* 사용 가능 위치: 전시 시퀀스 연출 의도 기록
* 왜 중요한지: 고개와 팔 동시 이동으로 방향이 바뀐 근거다.
* 수정 필요 여부: 보고서 본문에는 다듬어 사용

* 문장: “그냥 팔도 1200ms으로 해”
* 사용 가능 위치: 구현 판단 기록
* 왜 중요한지: 새 Arduino 명령을 만들지 않고 기존 `MOVE_BOTH`를 유지한 이유다.
* 수정 필요 여부: 보고서용으로는 사용하지 않고 작업 기록에 보존

### GPT 작성 초안/정리 문장

* 문장: “Raspberry Pi가 버튼 입력, WAV 음성 재생, 전체 시연 타임라인을 제어합니다.”
* 사용 가능 위치: 시스템 설명
* 왜 중요한지: Raspberry Pi 역할을 간결히 설명한다.
* 수정 필요 여부: 현재는 LED 제어도 포함하므로 “LED 제어”를 추가해 다듬는 것이 좋음

* 문장: “Arduino Mega는 USB Serial 명령을 받아 PCA9685를 통해 고개 SG92R 서보, 로봇 기준 오른팔 MG996R 서보, 카메라 좌우 회전 서보를 움직입니다.”
* 사용 가능 위치: 시스템 설명
* 왜 중요한지: Arduino와 PCA9685의 역할을 정확히 설명한다.
* 수정 필요 여부: 서보 모델명 중 카메라 서보 모델은 [확인 필요]

* 문장: “목표는 화려한 복잡 기능보다 반복 가능한 시연 흐름을 통해 사회적 의사소통 행동을 관찰할 수 있는 상황을 만드는 것이다.”
* 사용 가능 위치: 컨셉 방향 초안
* 왜 중요한지: 프로젝트가 복잡한 기능보다 반복 가능한 경험에 집중한다는 방향을 보여준다.
* 수정 필요 여부: 발표용으로는 표현 다듬기 필요

* 문장: “기술 자체보다 ‘아이의 자연스러운 상호작용 경험’과 ‘반복 관찰 가능한 전시/가정용 프로토타입’ 논리를 유지해야 함”
* 사용 가능 위치: 발표/보고서 작성 원칙
* 왜 중요한지: 기술 설명에 매몰되지 않도록 하는 기준이다.
* 수정 필요 여부: 없음

## 8. 아직 다듬어야 할 초안

* 컨셉명: [확인 필요]
* 대상 사용자군 정의의 발표용 문장: [확인 필요]
* 실제 음성 대사의 최종 문구와 녹음 출처: [확인 필요]
* 로봇의 감성 키워드와 외형 디자인 언어: [확인 필요]
* 로봇 외형, 기구 구조, 치수, 재료, 마감 설명: [확인 필요]
* 전시 부스의 전원 투입/철수 SOP: [확인 필요]
* 전시 자동 실행 방식의 최종 선택: systemd 방식인지 Desktop Autostart 방식인지 [확인 필요]
* 전원 OFF 버튼 sudoers 설정 완료 여부: [확인 필요]
* 카메라 LED 실제 밝기, 저항값, 배선 방향 검증: [확인 필요]
* 팔 180도, 카메라 30..150도 장기 안전성 확인: [확인 필요]

## 9. 다음에 만들어야 할 산출물

1. 실제 배선 사진 기반 핀맵 문서
   * 버튼 3개, GPIO23 LED, PCA9685 서보 채널, 전원/GND 공통 연결을 사진과 함께 정리
2. 전시 시연 SOP
   * 전원 연결, 자동 실행 확인, 전시 버튼 테스트, 카메라 버튼 테스트, 전원 OFF 버튼, 철수 절차
3. 발표자료용 컨셉 페이지
   * 문제정의, 컨셉 한 줄, 로봇 경험 설명, 대상 사용자 정리
4. 시스템 아키텍처 다이어그램
   * Raspberry Pi, Arduino Mega, PCA9685, 서보 3개, 버튼 3개, LED, WAV 출력 관계
5. 하드웨어 안전 체크리스트
   * 서보 범위, 케이블 걸림, 외부 5V 전원, 공통 GND, LED 저항, Arduino 업로드 전 승인
6. 현재 코드/배포 상태 업데이트 문서
   * `docs/09_CURRENT_STATE.md`를 실제 배포/업로드 상태와 맞게 갱신
7. 최종 보고서 목차 초안
   * 현재 문서에는 큰 흐름만 있고, 실제 보고서 구조는 아직 [확인 필요]
