d3s1gn0va/CapstonePy/PLANS.md

# PLANS.md

## 목적

이 문서는 다음 작업 후보를 한곳에 모아두기 위한 계획 노트다. 확정된 현재 상태는 `docs/09_CURRENT_STATE.md`를 우선한다.

## 단기 계획

2026-10-05 최신 후속 요청은 **iPhone 연결 없이 먼저 앱 코딩**이다. 인접 `KeepEye`에서 전시 체험 UI/앱 BLE 클라이언트/상태 검사를 먼저 구현하고, Pi의 대응 BLE 서비스·현장 안전 조건과 실제 iPhone 시험을 이어간다. 앱 계약은 `KeepEye/Docs/CUVO-Robot-Control.md`, 로봇의 실제 배포·시험 상태는 `docs/09_CURRENT_STATE.md`를 따른다. 이 변경은 기존 전시 재시작/자동 실행 활성화나 검증 잠금 해제를 허가하지 않는다.

아래 목록은 앱 작업 전 로봇 통합 계획이다. 최신 6축 기준/춤 결과는 [춤 구현](docs/20_DANCE_SESSION.md)을 우선한다.

* 완료: 기존 기본 프로그램을 유지한 별도 눈/음성/6축 통합 코드, 안전 프로필, 그룹 명령, 가상 검사와 Mega용 컴파일.
* 다음: CH1/CH3/CH4/CH5의 실제 축 방향, 초기 자세, 최소/최대와 인사/초대 각도 및 전원 검증.
* 이후: Pi와 펌웨어 설정 일치 -> 검사/프로그램 중지/포트 확인 후 필요한 펌웨어 업로드·검증 -> 사용자 요청한 배포/실물 시험 -> 자동 실행 전환. 2026-10-05 최신 위임에 따라 요청한 변경의 업로드에는 재승인을 묻지 않는다.
* 배선 완료를 각도/전원 검증 완료로 취급하지 않는다. 미확정 값은 임의의 90도나 과거 180도로 채우지 않는다.

아래는 이전 작업 후보이며 현재 최신 상태와 우선순위를 먼저 확인한다.

1. GitHub 인증 문제를 해결한 뒤 원격 저장소 push 재시도.
2. Raspberry Pi로 배포하기 전 `scripts/check_python.sh` 재실행.
3. 전시 자동 실행 방식이 실제 Raspberry Pi OS 환경에서 의도대로 동작하는지 확인.
4. 하드웨어 배선 사진 또는 회로도를 `docs/assets/wiring/`에 추가.
5. 로봇 외형, CAD, 기구 구조 이미지를 `docs/assets/robot_design/` 또는 `docs/assets/cad_exports/`에 추가.

## 개발 시험 항목

* 고개 0도에서 180도 이동은 개발 시험 항목이며 최종 전시 기능으로 확정되지 않았다.
* 전체 범위 테스트는 반드시 사용자의 명시적 승인 후 작은 위험 점검 절차와 함께 수행한다.

## 보류

* 요청하지 않은 Arduino Mega 업로드 및 반복 업로드. 요청한 변경에 필요한 업로드는 최신 위임과 안전 절차에 따라 진행할 수 있다.
* 서보 PWM 펄스 폭 변경.
* 서보 안전 범위 확대.
* 자동 실행 활성화 명령 실행.
