d3s1gn0va/CapstonePy/docs/09_CURRENT_STATE.md

# 09 Current State

## 2026-10-20 GitHub 소스 인수인계 기준

* 사용자 요청으로 Mac의 최신 앱/로봇 소스를 기존 KeepEye/CapstonePy 저장소에 반영할 기준을 정리했다. 양쪽 `CURRENT_SOURCE.md`와 공통 태그 `cuvo-baseline-2026-10-20`으로 소스 위치·프로토콜·현재 원점/춤·미리보기 전용 기능을 구분한다. 오래된 3채널 맥락 문서에는 최신 안내를 추가했다.
* 비밀키/실제 인증값/환경 파일/서명 자료/빌드 결과물은 제외한다. 앱 저장소는 비공개, 로봇 저장소는 기존 공개 설정을 유지한다. 예시 데이터·과거 시험·현재 구현을 구분하며 새로운 Figma 전시 앱이 이미 구현됐다고 취급하지 않는다.
* 로컬 Python 114개 중 110개 통과/선택 CAD 4개 건너뜀, 시뮬레이터 모델 14개 통과, 가짜 PWM C++ 6축/교대 명령 검사 통과, 앱 로직 26개 통과/iOS 기기용 서명 없는 빌드 성공. 앱 검사 캐시의 macOS 파일 속성 문제는 임시 빌드 폴더 재검사로 분리했다. 이번 작업은 소스 보관/공유이며 Pi 접속·배포/서보 실행/앱 기기 재설치를 하지 않는다.

## 2026-10-18 공유 안무 실행 기록과 CUVO Groove 미리보기

* 사용자 요청으로 오프라인 3D 도구를 실제 `IntegratedSequence`의 가상 실행 기록을 재생하는 구조로 확장했다. schema 2 JSON → 기존 Step/실행기 → 20ms 관절값·실제 OLED 프레임·오디오 시점 → 브라우저 번들 순서다. 브라우저의 별도 안무 계산을 제거하고 실제 명령의 선형 보간/반올림을 모델링했다. 원본 CAD 눈구멍 마스크와 OLED 렌더러를 공유하며 소스 해시를 표시한다.
* `CUVO Groove`는 100BPM/16박의 전용 상체 춤이다. 교대 스윙 → 양팔 리듬 → 대각선 포즈/고개·정수리 연동 → 깜박임 → 기본 자세로 구성했고 준비/복귀 포함 가상 실행 12.34초다. 직접 합성한 kick/snare/hat WAV를 사용한다. 기존 춤도 비교 선택으로 유지했으며 **Pi 기본 춤을 교체하지 않았다**.
* 새 사용자 기구 정보: 팔꿈치는 180도 완전 펼침..120도 굽힘 사이 수동 프리스탑이다. 좌우 별도 파라미터/기본 150도로만 표시하며 춤 중 고정한다. 모터 채널/명령을 추가하지 않았다. 재생/일시정지·재개/다시 시작/정지/탐색/0.25·0.5·1배속/선택적 소리와 눈 출력 모니터를 제공한다.
* 로컬 Python 114개 중 110개 통과·기존 CAD 4개 건너뜀, JavaScript 14개 통과. 별도 임시 Chrome/Playwright로 1440·820·390·320px 4개 화면/96개 검사 통과, 화면 픽셀·프레이밍·관절 방향·수동 팔꿈치 유지·OLED/시선/깜박임·소리 디코딩·일시정지/속도·춤 끝까지 재생과 복귀 확인. 브라우저 오류/외부 요청 없음. 앱 내 기존 file 탭 자동 조작은 URL 정책으로 제한되어 사용자가 새로고침 후 재생해야 한다.
* Pi SSH/전송·배포/Arduino 업로드/실물 서보·스피커 동작 없음. 프로필·기존 `dance_config.json`·펌웨어의 작업 시작 해시가 유지됨을 확인했다. 검증 플래그는 false 그대로다. 새 JSON을 명시적으로 읽는 일반 실행 진입점은 준비했지만 하드웨어 잠금을 우회하지 않는다.
* 실제 시작 위치·서보 추종/USB 지연·부하·충돌을 보장하는 시뮬레이션이 아니다. 다음은 화면 연출을 사용자와 확인하고 실제 팔꿈치 각도/공간/5V/동시 부하를 점검한 뒤 별도 실물 배포를 진행하는 것이다. [공유 구조와 안무](22_OFFLINE_CHOREOGRAPHY_PREVIEW.md), [도구 사용법](../tools/servo-simulator/README.md)을 따른다.

## 2026-10-13 춤 Y 상대 45 / X 상대 0..80

* 사용자 요청으로 춤 Y 상승을 상대 45, X 교대를 상대 0..80으로 변경했다. 실제 명령은 오른팔 X 45..125/왼팔 X 135..55, 오른팔 Y 45/왼팔 Y 135다. 고개 60..120/550ms/4회/눈 시선/기본 자세는 유지했다. 일반 펌웨어 범위와 PWM 변경·Arduino 재업로드는 없다.
* `dance_config.json`과 한 번 실행용 제한을 Mac/Pi에 함께 저장하고 원본 해시 일치·Pi 설정/문법·범위 검사를 확인했다. 관련 Python 10개, 시뮬레이터 10개/4개 화면 크기 검사 통과. 기존 설정 두 파일은 Pi의 `~/capstone-robot-build/dance-y45-x80-20261013-ef_h10i1/`에 백업했다.
* 요청한 실제 춤 1회가 23.48초/worker completed/종료 코드 0으로 완료됐다. 이후 기본 자세 명령, 지속 눈 깜박임과 BLE 대기를 복원해 idle/motion_ready=true/eyes_idle_armed=true/NRestarts=0/active 확인. 실제 연출 평가는 사용자 확인이 필요하다. 다음 앱/수동 춤 실행도 새 설정을 사용한다. 아래 0..60/Y30은 이전 시험 기록이다.

## 2026-10-13 새 팔 원점 및 전원 전환 자세

* **최신 후속: Pi/Arduino 배포 완료.** 사용자 요청으로 SSH 연결했고 추가로 서보 전원 ON/보드 5V 선택을 확인했다. 기존 서비스 idle 확인 후 정상 정지/Serial 비점유 확인, 기존 변경 파일·서비스·스케치 백업을 남겼다. 별도 `~/capstone-robot-build/neutral_20261013/`에서 실제 Mega 컴파일(Flash 18906/SRAM 3963바이트), 원본 해시 일치, `--verify` 업로드 성공. PING/CAPS에서 새 6축 범위·기본값 일치를 확인했다. PWM은 그대로다.
* 새 Pi 코드 4개와 서비스 옵션을 설치했다. 첫 `MOVE_GROUP,3000,0,90,1,45,2,90,3,0,4,135,5,180`의 ACK/DONE/STOP 확인 후 서비스 대기 시작, 정상 서비스 종료 복귀의 성공 종료 코드/실패 표시 없음 확인, 재시작 후 idle/motion_ready=true/NRestarts=0으로 10초 유지했다. boot enable, Arduino·USB 사운드보드 유지 확인. 사용자 등록 인증정보와 기존 자동 시작 차단은 보존했다.
* 사용자 후속 "응"으로 새 기본 자세의 양팔 내림/고개·정수리 정면을 확인했다. 요청한 새 춤을 1회 실행 후 다시 요청해 총 2회 실행했다. 각 23.72/23.46초, worker completed/종료 코드 0, 기본 자세 복귀 명령과 완료 후 눈 깜박임·Bluetooth 대기 복원을 확인했다. 마지막 idle/motion_ready=true/eyes_idle_armed=true/NRestarts=0/active다. 자동 반복이나 새 범위 끝점 시험은 하지 않았다. 새 춤의 실제 연출 평가는 사용자 확인이 필요하다.
* Pi 자체 재부팅·OS 종료 시험과 전체 X 0..180 실물 범위 시험은 아직 하지 않았다. 독립 전압·부하 계측/정식 검증 플래그 변경/iPhone 재설치/Git 작업 없음. 아래의 미배포 문장은 이번 배포 이전 준비 기록이다.

* 사용자 새 기준: 오른팔 X 0..180/원점 45, 왼팔 X 0..180/원점 135/감소 방향, 왼팔 Y 135..180/원점 180/감소 방향. 고개·정수리 45..135/90과 오른팔 Y 0..45/0은 유지한다. 사용자는 문제 서보 교체와 기구 간섭 정리를 확인했다. 전압·부하 계측과 새 원점 실물 시험은 아직 없으며 기존 확인 플래그를 true로 바꾸지 않았다.
* Mac 프로필/펌웨어 범위·기본값·춤 제한·관련 검사와 오프라인 시뮬레이터를 갱신했다. 양팔 X 상대 범위는 -45..135, 왼팔 Y는 0..45다. 0..60 춤은 오른팔 45..105/왼팔 135..75, Y +30은 30/150이다. 550ms/4회/눈 설정/PWM은 유지했다. 옛 브라우저 자세 저장은 새 원점에 재사용하지 않는다.
* `power_pose.py`와 BLE의 명시적 `--home-on-start-stop`을 준비했다. 부팅 준비/정상 서비스 종료에서 6축 기본 자세로 복귀하고 CAPS 일치/Serial 잠금/5V·공간 확인/완료 응답을 요구한다. 앱 STOP·통신 소실·오류는 추가 복귀 이동 없음. 부팅 실패와 종료 실패는 같은 부팅에서 자동 재시도하지 않는다. 로컬 서비스 원본에 새 옵션 및 종료 대기 45초를 반영했다.
* **이전 준비 시점:** Pi SSH 응답 없음으로 배포/업로드는 보류했었다. Mac Python 107개 중 103개 통과·기존 CAD 4개 건너뜀, 가짜 PWM C++ 검사, 시뮬레이터 10개 및 4개 화면 크기 검사 통과. 이후 위 배포에서 관련 Python 34개를 다시 검사해 모두 통과했다.
* 다음: 새 춤의 사용자 관찰과 재부팅/OS 종료 흐름을 확인한다. 별도 서보 전원을 복귀 전에 끊으면 안 되며 강제 전원 차단/정전 복귀는 보장하지 않는다. [최신 기준](08_CALIBRATION_AND_SAFETY.md)이 아래 이전 각도보다 우선한다.

## 2026-10-13 로컬 3D 관절 시뮬레이터

* `tools/servo-simulator/index.html`에 화면 전용 6축 도구를 추가했다. 인터넷/서버 없이 브라우저에서 실행한다. 현행 `robot_motion_profile.json`과 `dance_config.json`을 빌드 시 읽으며 실제 로봇 설정은 변경하지 않는다.
* 고개/정수리 기준 90, 오른팔 X/Y 기준 0, 왼팔 X 기준 180/Y 기준 165와 현재 지정 범위를 적용했다. 상대/서보 입력 전환, 범위 보정, 기본 자세, 시점/축 표시와 춤 화면 미리보기를 제공한다. 왼팔은 감소 방향, 고개/정수리 45는 로봇 왼쪽이다.
* 모델은 단순화된 외형으로 실제 CAD·충돌·하중·전원 안전 검증이 아니다. 기존 검증 플래그/펌웨어/PWM/BLE 동작은 그대로다. SSH/Pi 배포/Arduino 업로드/실물 서보 시험을 하지 않았다.
* 모델 검사 10개 통과. Playwright로 데스크톱/태블릿/모바일/320px에서 캔버스 비어 있지 않음·조작에 따른 픽셀 변화·기준/역방향·고개-정수리 상속·춤 종료·범위 보정·가로 넘침 없음·외부 통신 없음 확인. [실행과 모델 한계](../tools/servo-simulator/README.md)를 따른다.

## 2026-10-06 기본 앱 디자인 및 BLE 춤 서비스

* **최신 후속: 춤 정상 완료 후 눈 깜박임 대기 구현·Pi 배포.** `idle_eye_worker.py`는 눈만 정면에서 계속 깜박인다. 기존 눈구멍/좌우 배치/10px 선/밝기 255를 유지하고 3초 열림 → 0.12초 닫힘 → 0.08초 유지 → 0.22초 열림을 반복한다. 다음 명시적 춤 시작 전에 눈 대기 종료와 OLED 잠금 해제를 확인한다. 실패하면 춤 시작을 거부하며 오류/중단을 정상 완료로 바꾸지 않는다. 정상 완료 후 폰 연결이 끊겨도 눈 대기는 유지한다.
* 배포 직전 Pi 상태 `completed`를 읽어 확인했고, 서비스 중지 후 그 완료 상태만 비공개 임시 대기 표시에 반영했다. 수정 서비스/눈 대기 실행이 10초 유지·서보 Serial 비점유·서비스 active/NRestarts=0 확인. 이 작업에서는 춤/서보를 실행하지 않았으며 사용자의 화면 관찰과 다음 춤으로의 실물 전환 확인은 남아 있다. Python 99개 중 95개 통과·기존 CAD 4개 건너뜀, Mac/Pi 문법·비장치 설정 검사 통과. iPhone/Arduino/PWM/Git 작업 없음.
* 눈 대기는 정상 완료한 경우에만 켠다. 같은 부팅에서 서비스 재시작은 완료 후 대기 표시를 유지하지만 새 Pi 부팅에서는 자동으로 춤/눈 대기를 시작하지 않는다. 눈 대기 오류는 자동 반복 재시도를 하지 않고 BLE 제어/안전 감시는 유지한다. 아래의 '대기에서는 OLED/GPIO를 열지 않는다'는 이전 동작이며, 현재 완료 후 대기는 OLED 신호 핀/SPI만 사용하고 Serial/서보/음성은 열지 않는다.

* **최신: 학교용 오프라인 부팅 대기/등록 폰 재연결 구현·배포.** 사용자 요청으로 새 `cuvo-ble.service`를 enable하고 Linger=yes 설정. 사용자 실제 재부팅 후 새 boot ID, 부팅 15.9초 서비스 시작/NRestarts=0/active·enabled, USB 정상, 옛 전시 자동 실행 차단을 확인했다. 앱/서비스 재시작 및 Pi 재부팅 후 앱 재실행에서 **새 코드 없이 제어권 true/idle/지속 revision 증가** 확인. 부팅·연결만으로 Serial/서보를 열거나 춤을 실행하지 않는다.
* 인증: 최초 코드 등록 시 앱의 256비트 난수 토큰을 iPhone Keychain(로컬/동기화 없음)에 저장한다. Pi는 사용자 비공개 상태 폴더 0700/파일 0600에 토큰 해시·등록 client ID·페어링 장치 경로만 저장한다. `session.resume`은 암호화·페어링·등록 토큰/식별자 일치를 요구하며 임시 코드 만료 후에도 가능하다. 최초 연결 코드와 실제 인증값/기기 주소는 저장소 문서에 기록하지 않는다. 한 기기 제어권/3초 watchdog/35초 실행 제한/정지 응답 확인 유지.
* 준비: 최신 사용자 서보 전원 ON 확인. 새 서비스는 승인된 고정 춤 범위만 명시적 앱 시작으로 허용하며 USB/SPI/PipeWire 준비가 없으면 시작을 막는다. 전압 센서는 없으므로 5V·기구 공간은 매 시작 확인창에서 사용자가 확인한다. 일반 프로필의 verified/power_verified는 false 그대로다. 기존 GPIO 버튼은 옛 실행부에 남아 있고 새 BLE 대기 서비스에 아직 통합되지 않았다.
* 검사: 앱 로직 26개 통과, 실제 iPhone 개발 서명 빌드/설치 성공, Python 90개 중 86개 통과·기존 CAD 4개 건너뜀/문법 검사 성공. 저장 정보 재로드, 잘못된 토큰/다른 기기/권한 거부, 읽기만으로 lease 연장 금지, 정지 중 재인증 대기, 다른 인증 요청의 동작 응답 덮어쓰기 방지를 검사했다. 앱 개발 서명 만료는 **2026-10-13 01:05 KST**다. 실제 춤/Arduino 업로드/서보 명령/Git 작업은 이 배포에서 하지 않았다.
* 남은 검증: 외장 사운드카드는 사용자 확인상 분리 상태다. 재연결 후 USB 안정성/출력 장치 확인, 실제 무인터넷 조건의 춤·중단·링크 소실 시험, 새 실행부의 물리 종료 버튼 통합이 남아 있다. 로그와 자동 시작 설정 성공을 모든 실물 동작 검증 완료로 해석하지 않는다.

* USB 복구 확인: 사용자 재부팅 후 새 boot ID/SSH 접속, Arduino CH340 USB 인식 및 by-id→ttyUSB0 경로 복구를 확인했다. 사운드카드는 분리 상태, 서보 전원은 OFF다. 현재 부팅의 xHCI 장애 기록 없음, Arduino USB는 10초간 유지, `get_throttled=0x0` 확인. 옛 전시 autostart는 원본 보존/차단 상태이며 로봇 프로세스가 자동 시작하지 않았다. 별도 BLE 서비스만 **확인 인수 없이** 다시 준비해 idle/`motion_ready=false`로 춤을 잠갔다. Serial/PING/음성/서보 시험은 하지 않았다. 다음은 서보 전원 OFF 상태로 사운드카드 재연결 전후 USB·ALSA·드라이버 로그 비교다. 사운드카드가 장애 원인인지는 아직 미확정이다.

* USB 복구 준비: 사용자가 서보 전원 OFF 및 외장 USB 사운드카드 분리를 확인했다. 기존 `robot-demo.desktop`을 같은 autostart 폴더의 `.desktop.disabled-cuvo-usb-recovery-20261006` 접미사 파일로 옮겨 자동 실행을 차단했으며 원본 내용 SHA-256 일치를 확인했다. 춤 worker 없음/제어권 없음 확인 후 별도 BLE daemon을 정상 종료했다. **현재 BLE 서비스도 중지 상태**다. `sudo -n reboot`는 암호 필요, 표준 logind 재부팅도 대화형 인증 필요로 거부됐다. 따라서 아직 재부팅/USB 복구는 하지 못했고 사용자의 터미널 인증이 필요하다. 서보/Arduino/PWM 변경 없음. 옛 자동 실행을 임의로 복원하지 않는다.

* 외장 USB 사운드카드 후속 진단: 사용자가 새 사운드카드 연결을 알렸다. 커널 로그에서 `08bb:2902 / USB PnP Sound Device / C-Media Electronics Inc.` 인식 및 `snd-usb-audio` 등록을 확인했고 현재도 `snd_usb_audio` 모듈은 로드돼 있다. 연결 후 약 3576초 뒤 xHCI 장애로 사운드카드와 CH341 Arduino가 함께 해제됐다. 현재 ALSA에는 HDMI/내장 Headphones만 남아 있다. 드라이버 부재로 단정하지 않으며 사운드카드/USB 전원·접촉/커널 문제 중 실제 원인은 미확정이다. 다음 진단은 안전하게 USB를 복구한 뒤 사운드카드 제외/추가 전후 비교다. 드라이버 설치·제거/설정 변경/재부팅/소리 재생/서보 실행은 하지 않았다.

* USB 장애 후속 확인: 사용자는 Pi–Arduino 케이블이 연결돼 있다고 확인했다. Pi 커널에는 `xHCI host controller not responding, assume dead`, `HC died; cleaning up`과 CH341/USB 장치 연결 해제 기록이 있다. 현재 USB Serial 장치가 없고 `get_throttled=0x0`이다. 케이블 미연결이나 Arduino 고장으로 단정하지 않는다. USB 제어기 장애를 확인했지만 발생 원인은 미확정이다. 기존 사용자 autostart `robot-demo.desktop`은 활성 상태이므로 안전 조치 없이 재부팅하면 안 된다. 이 확인에서는 재부팅/USB 제어기 reset/Serial 열기/서보 실행/자동 실행 설정 변경을 하지 않았다.

* 최신 후속 보고: "로봇 응답이 늦어지고 있어요". 당시 Pi는 idle/제어권 유지/매초 요청 수신. 앱은 암호화 write 확인 뒤 전체 read도 수행하고 알림과 별도 해석한다. Pi는 성공한 claim의 요청 ID를 후속 read에 보존한다. 3초 안전 기준은 변경하지 않았다. 수정 앱 설치 및 별도 대기 BLE 서비스 갱신 후 사용자 "안 떠" 확인, Pi에서도 20초간 제어권 유지/revision 84→132 증가 확인. 앱 로직 20개/Python 83개 중 79개 통과·기존 CAD 4개 건너뜀/문법 검사 성공.
* 같은 후속 확인에서 춤 worker가 준비 단계 Serial 열기 `Errno 19 / No such device`로 실패했다. 읽기 전용 확인에서 by-id/ttyACM/ttyUSB 장치가 없고 lsusb에는 root hub만 있었다. **현재 error/준비 false/새 시작 잠금**이며 춤 성공이 아니다. 다음은 Arduino USB 연결 확인이다. 에이전트의 서보 시작/Arduino 작업/오류 초기화를 위한 자동 재시작/기존 전시·자동 실행·Git 작업은 없다.

* 후속 사용자 보고: 코드 입력 화면에 들어가기 전에 연결 확인이 취소된다. 실제 iPhone에서 상태 알림 구독 `CBATTErrorDomain(1): The handle is invalid.` 확인. 서비스/명령/상태 주소를 v1 고정값으로 바꾸고 Pi 대기 BLE 서비스만 갱신했다. 앱 서비스 무효화/1회 재탐색과 구독 전 초기 응답 보존도 추가했다. 사용자가 iPhone의 해당 기기를 지운 뒤 입력창 순간 진입 검사는 통과했지만, 사용자가 다시 입력창이 없다고 보고했다. 후속 시험에서는 BLE 연결은 유지되고 상태가 없는 것을 확인했다. 코드 제출 전에는 public 상태 read로 조회하고 제출 후에만 암호화 명령/heartbeat를 사용하도록 수정했다. 전체 read와 20바이트 알림을 분리해 처리하고 Pi Read Blob은 한 스냅샷을 유지한다. **최종 실제 iPhone 검색/선택/코드 입력창 15초 유지 검사 1개 통과**. 최종 개발 서명 수정 앱 빌드/설치/실행 완료. 인증 후 15초 유지 여부는 사용자 확인 대기다. 진단 시험은 코드를 입력하거나 서보를 시작하지 않았다.
* 최신 검사: 앱 로직 19개 통과, Python 82개 중 78개 통과/기존 CAD 4개 건너뜀. GATT 고정 주소/속성/UTF-8 분할, 전체 read·알림 교차와 Read Blob 동일 스냅샷 검사 포함. 이전 아래 검사 수보다 우선한다.
* 이후 사용자 코드 제출에서 `CBATTErrorDomain(15): Encryption is insufficient.` 확인. 명령 암호화 조건은 유지한다. Pi에 iPhone의 이전 bond가 남아 있어 사용자 명시 승인 후 **해당 iPhone 1건만** 제거했다. 다른 페어링 3건 보존, adapter Powered/Pairable 및 대기 BLE 재등록 확인. 새 코드 제출 후 사용자 "오 된것같은데??" 응답. Pi의 **새 Paired/Bonded/Connected, 제어권 true, 20초 동안 1초 간격 revision 증가**를 확인했다. 최종 확인도 idle/제어권 유지/준비 true다. 인증·지속 연결 성공이며 실제 춤/서보는 이 진단에서 실행하지 않았다.

* 첫 연결 후 사용자 보고: "연결 코드를 입력하면, 연결이 됐다가 바로 끊기는것같은데". Pi에서 BLE 장치는 Paired/Connected 상태였으나 heartbeat 소실로 제어권이 해제된 것을 확인했다. 앱의 전면 상태 변화에 맞춰 주기 작업을 다시 시작하고 iOS 시스템 페어링 창의 일시 비활성에서는 대기 연결을 끊지 않도록 수정했다. 앱 로직 검사는 17개로 확대했고 새 개발 서명 빌드가 통과했다. 수정판 재설치/대기 서비스의 코드 갱신 후 지속 연결 실물 확인은 사용자 평가 대기다. 3초 동작 watchdog 자체는 완화하지 않았다.

* 사용자 요청: 쿨톤 흰색, 전시 체험모드 제거, 주요 요소 곡률/투명도와 큰 제목 축소, 실제 Bluetooth 춤 연결. 앱 배경 #F6F8FB, 제목 26~28pt, 버튼 곡률 12pt/카드 8pt, 주요 불투명 컨트롤로 수정하고 실제 iPhone에 개발 서명 앱을 설치했다.
* 사용자 확인: 새 550ms/팔 X 상대 0..60의 "5V와 새 범위의 이동 공간을 확인했어". 이 지정 춤만 명시적 앱 시작으로 허용한다. 전체 `verified`/`power_verified`는 변경하지 않는다.
* 완료: BlueZ GATT/임시 코드/한 기기 제어권/3초 heartbeat/중복 명령/35초 춤 제한/확인된 정지 응답을 구현하고 별도 Pi 개발 폴더에 배포했다. 광고 등록, idle/준비 상태, Serial 비점유와 최근 로그 확인 완료. 대기/연결에서는 하드웨어를 열지 않는다.
* 검사: iOS 검사 빌드/개발 서명 빌드/설치, Mac 앱 로직 19개 통과. Python 문법 통과, 82개 중 78개 통과/기존 CAD 4개 건너뜀. Pi 라이브러리 및 비장치 preflight 통과.
* 진행 중/다음: 실제 iPhone 연결과 화면 평가 → 새 춤/정지/비활성/링크 소실 실물 확인. 현재는 설치·서비스 대기까지이며 춤을 대신 실행하지 않았다.
* 위험/미확정: 첫 PWM 급이동, 동시 부하 여유, Just Works의 MITM 한계, daemon/OS 장애에 독립적인 하드웨어 watchdog 없음. 정지 실패 시 현장 전원 차단이 필요하다.
* Arduino 수정/컴파일/업로드, 기존 전시 프로그램 재시작, 자동 실행 변경, Git commit/push 없음. [현재 운용 문서](21_BLUETOOTH_CONTROL.md)가 아래 구현 이전 BLE 기록보다 우선한다.

## 2026-10-05 iPhone 없이 앱 첫 구현

* 사용자 요청에 따라 인접 `KeepEye` 프로젝트에서 전시 체험 첫 화면, Core Bluetooth 클라이언트, 시작/정지/상태 모델, 별도 화면 예시와 Mac용 로직 검사를 추가했다. iOS 서명 없는 빌드와 Mac 로직 검사 14개 통과를 확인했다. 기존 보호자용 예시 화면/작업은 보존한다.
* **Pi 대응 BLE 서비스/페어링/제어권/watchdog은 아직 미구현·미배포**다. 새 GATT 규격은 앱의 제안 계약이며 현재 Pi 서비스가 아니다. 기존 Python/Arduino/프로필 검증 값/자동 실행을 변경하거나 서보를 실행하지 않는다.
* 실제 iPhone 연결과 화면/로봇 연동 검증은 이후 진행한다. 자세한 구현·검사 기록은 앱의 `Docs/CUVO-Robot-Control.md`를 따른다. 이 작업으로 아래 새 550ms/60도 춤의 실물 재시험이 완료된 것은 아니다.

## 2026-10-05 춤 리듬·팔 폭·시선 수정

* 사용자 후속 확인: 직전 650ms/팔 상대 0..45/시선 10px의 춤에 "다 잘 됐어"라고 답했다. 실물 시연 관찰 확인이며 독립 부하 계측/전체 안전 범위 검증과 구분한다.
* 최신 설정은 한쪽 이동 **550ms**, 팔 X **상대 0..60도 교대**, 눈 좌우 **14px**다. 오른팔 실제 0..60 / 왼팔 실제 180..120으로 변환한다. 고개 60..120, 팔 Y 상대 +30, 아래 시선 8px, 4회 반복과 준비/복귀 시간은 유지했다. 일회성 시험의 X축 범위 검사도 CH1=0..60/CH4=120..180으로 일치시켰다.
* Mac과 별도 Pi 시험 폴더에 설정/시험 실행부 두 파일을 저장하고 SHA-256 일치, Pi 문법·장치 접속 없는 계획 검사를 확인했다. Python 검사, 단위 검사 68개 중 64개 통과/기존 CAD 4개 건너뜀, 새 550ms/60도 가짜 PWM 검사 통과. 가상 실행은 약 18.63초다.
* **새 설정의 실물 재시험은 하지 않았다.** 팔 폭 확대와 더 빠른 이동으로 충돌·과부하 위험을 다시 확인해야 한다. 일반 Arduino 안전 범위 안이므로 펌웨어/PWM/프로필 검증 플래그를 바꾸거나 재업로드하지 않았다. 기존 전시 코드/자동 실행/프로그램 재시작/Git 작업도 없다.

## 2026-10-05 일회성 춤 실물 명령 시험 완료

* 사용자 요청 "춤 테스트 볼수있어?"와 후속 "5V와 움직일 공간을 확인했어"에 따라 지정 범위의 일회성 시험을 실행했다. 이는 독립 전원 부하 계측이나 정식 6축 검증 완료를 뜻하지 않으며 프로필 확인 플래그는 false 그대로다.
* 별도 Pi 시험 폴더 `~/capstone-robot-build/dance_test_20261005/robot_demo/`에 코드를 복사했다. 기존 `~/robot_demo/`, 자동 실행 설정과 기존 OLED 시험 파일은 바꾸지 않았다. 최신 펌웨어는 Mega 컴파일(Flash 18906 / SRAM 3963바이트), 소스 해시 일치와 Serial 비점유 확인 후 업로드/검증 완료했다. 부팅 시 6축 PWM은 꺼진다. 이후 PING/CAPS에서 최신 6축 범위 일치를 확인했다.
* 새 `test_dance_once.py`는 명시적 5V/기구 확인 인수, 5축 제한, 순서가 정해진 명령 1회, 35초 실행 제한을 사용한다. 정수리 CH2는 활성화/이동하지 않는다. 정상 통합 프로그램의 검증 잠금은 유지하고 시험용 권한을 정식 검증 플래그로 대체하지 않는다.
* 첫 실행 준비는 시스템 Python의 `luma` 부재로 **이동 명령 전 중단**됐다. 기존 `~/cuvo_oled_test/.venv/bin/python`에 필요한 라이브러리가 모두 있어 이를 사용했다. 추가 설치/재업로드 없이 실행한 실제 명령 시험은 **21.15초 / completed / error=None / 종료 코드 0**, 고개·양팔 준비/8구간 교대/복귀, 새 음성 3개와 끝 깜박임 완료 후 `ACK,STOP`을 확인했다. 사용자가 후속 "다 잘 됐어"로 당시 시연을 확인했다. 이는 위 새 550ms/60도 설정의 결과가 아니다.
* 검사: Python 문법, 68개 단위 검사 중 64개 통과/기존 CAD 검사 4개 건너뜀. 중복/추가 명령 거부, 정수리 제외, 미확인 정상 실행 거부, 시간 제한 중단을 검사했다. 자동 반복, 전시 재시작, 자동 실행 변경, Git 작업은 하지 않았다. Pi 전원은 종료하지 않았다.

재실행 방법과 범위는 [춤 시험 안내](20_DANCE_SESSION.md#일회성-실물-시험)를 따른다. 아래 '미배포/컴파일 미실행'은 이 시험 이전 기록이며, 기존 전시용 폴더로의 통합 배포와 BLE 앱 연결은 여전히 미완료다.

## 2026-10-05 양팔 교대 춤 로컬 구현

아래 새 기록이 이전 시험 기록보다 우선한다. 현재 Pi의 전원/프로세스/펌웨어 상태는 이번 작업에서 원격 확인하지 않았다.

* 완료: 사용자 최신 기본값/안전 범위를 Mac 프로필과 Arduino 일반 명령에 반영했다. CH0/CH2=45..135/기본 90, CH1=0..90/기본 0, CH3=0..45/기본 0, CH4=90..180/기본 180, CH5=130..165/기본 165. 오른팔 X는 SG90이다. 이전 끝점 `TEST_*` 명령은 새 범위와 충돌하므로 로컬 펌웨어에서 거부한다. PWM 50Hz/1000..2000us는 그대로다.
* 완료: 사용자 정정 "x축 -15도는 내 실수야. 0도~45도로 정정할게" 반영. 새 `dance_config.json`/`dance_sequence.py`에서 상대 Y 30도 상승, 상대 X 0~45도 양팔 교대, 고개 60↔120도/650ms/좌→우 4회(8구간)를 계획한다. 눈은 고개 방향의 아래 대각선으로 함께 이동한다. Y 상승 1200ms, 복귀 1800ms, 시선 10px/아래 8px는 실물 연출 확인 전 조정값이다.
* 완료: '에셋 생성기'에서 확인한 최신 음성 5개를 재생용 WAV로 변환했다. 새 춤은 '여기 봐봐', '따라해봐', '같이놀아줘서고마워. 또만나'만 사용한다. 옛 두 WAV는 삭제하지 않았으며 새 춤에서 사용하지 않는다.
* 검사: Python 문법 통과, 64개 단위 검사 중 60개 통과/기존 CAD 가져오기 4개는 ezdxf 부재로 건너뜀, 가짜 PWM C++ 검사 통과. 가상 춤 약 19.53초 완료. 실물 실행 잠금은 장치 접속 전에 거부하는 것을 확인했다. 실제 Mega 대상 컴파일은 하지 않았다.
* 미진행: Pi 배포, Arduino 컴파일/업로드, 실물 서보·OLED 시험, 프로그램 재시작/자동 실행 변경, Git commit/push, 앱/BLE 구현.
* 다음 작업: 5V 공급과 6축 기구 검증 → 실제 Mega 컴파일/요청된 업로드 및 Pi 배포 → 짧은 구간별 실물 확인 → BLE 시작/중단/상태 연결. 모든 `verified` 및 `power_verified`는 false로 유지했다.
* 위험/미확정: 5V 3A 공급의 동시 서보 부하 여유, 팔 회전의 실제 앞뒤 방향, 첫 PWM 활성화의 급이동, 650ms 리듬과 시선 크기의 실물 적합성. 앱은 BLE 명령 연결을 계획할 수 있지만 현재 연결되는 기능은 없다.

구체적인 상대/실제 각도와 실행 순서는 [20_DANCE_SESSION.md](20_DANCE_SESSION.md)를 따른다. 이하의 '아직 미반영', 이전 기본 45/180도 및 고정 시험 설명은 당시 상태 기록이다.

## 2026-10-05 두 눈 출력 배치 실물 확인 및 기본값 저장

* 사용자 확인: `--swap-displays --gaze --seconds 15` 실행 후 "오 된다. 지금 설정이 맞아.". 승인된 출력 배치는 CE1=정면 관찰자 왼쪽/로봇 오른쪽, CE0=정면 관찰자 오른쪽/로봇 왼쪽이다. 322프레임/15.0초/21.5fps/종료 코드 0, 화면 정리 완료. 앞선 한쪽 무출력의 전기적 원인은 별도 확정하지 않는다.
* Mac 실행 스크립트의 기본 인수에 `--swap-displays`를 저장하고 Pi 시험 폴더에도 같은 스크립트를 반영한다. CE1 DC=BCM4/RST=BCM18, CAD +3px/선 10px/밝기 255/좌우 28px·복귀 깜박임/15초 기준 유지. 기본 시험은 깜박임, 시선까지 포함한 재실행은 `bash ~/cuvo_oled_test/run_oled_pair_test.sh --gaze`다. 직접 Python 실행은 `--swap-displays` 필요. 통합 실행부의 별도 배치는 아직 자동 반영하지 않았다.
* 저장 작업에서는 추가 화면 시험·서보 명령·프로그램 재시작·Arduino 업로드·자동 실행·Git 작업 없음.

## 2026-10-05 기존 두 눈 애니메이션 재시험

* 후속 사용자 관찰: "좌 우 반대로 한것같은데", "로봇 왼쪽 눈이 안나와". 두 눈 실물 표시 성공으로 취급하지 않는다. Pi 출력 어댑터 SHA-256은 Mac과 일치하며 CE1 DC=BCM4/RST=BCM18 반영 확인, SPI0.0/0.1 존재, 부팅 설정에서 명시적 1-Wire/I2S 핀 중복은 발견하지 않았다. 좌우 배치는 정면 관찰자 기준의 기존 가정이며 실제 로봇 좌우/CS 연결 확인 대기다. 원인을 단정하거나 핀을 임의 변경하지 않는다. 실행 종료/화면 정리 기록과 실물 출력 성공 여부를 구분한다.

* Pi 시험 폴더의 CE1이 이전 DC=BCM16/RST=BCM26으로 남아 있어, Mac의 기존 배선 변경본 DC=BCM4(물리 7)/RST=BCM18(물리 12) 출력 어댑터만 반영했다. Pi 문법 검사 및 중복 프로세스/SPI 장치 확인 후 `--gaze --seconds 15` 시험 성공: 326프레임, 15.0초, 평균 21.7fps, 종료 코드 0. 좌우 이동 28px/0.2초, 0.8초 바라보기, 복귀 후 깜박임, 밝기 255, CAD 눈구멍 +3px 및 선 10px 유지. 종료 후 두 화면 지움/시험 프로세스 없음 확인. 실물 표시 및 최신 재배선 확인은 사용자 평가 대기다.
* Arduino Serial을 열지 않았고 서보 이동/재시작/업로드/자동 실행/Git 작업 없음. 사용자 최신 고개·정수리 기준은 범위 45..135 / 정면 90 / 로봇 기준 왼쪽 45다. 일반 펌웨어·통합 프로필은 아직 이전 0..90/정면 45이므로 전체 코드 반영이 필요하다. 최신 팔 기준은 아래 절을 따른다.

## 2026-10-05 사용자 팔 기준 확정 및 고개·정수리 90도 명령

사용자가 직접 지정한 최신 실제 서보 명령 범위/팔 내린 값이다. 아래의 이전 추정값보다 우선한다. 코드에 적용하거나 독립 계측으로 검증한 것은 아니다.

| 축 | PCA9685 | 사용자 지정 범위 | 팔 내린 명령값 |
| --- | --- | --- | --- |
| 오른팔 X | CH1 | 0..90 | 0 |
| 오른팔 Y | CH3 | 0..45 | 0 |
| 왼팔 X | CH4 | 90..180 | 180 |
| 왼팔 Y | CH5 | 130..165 | 165 |

* 사용자 요청에 따라 기존 고정 시험으로 고개 CH0=90 / 정수리 CH2=90을 각각 3000ms 순차 명령했다. SSH/포트 비점유/PING/각 ACK·DONE 및 마지막 ENABLED/IDLE, 종료 코드 0 확인. 실제 움직임은 사용자 확인 필요다.
* 코드 변경·Arduino 업로드·전시 재시작 없음. Serial 접속 리셋으로 기존 팔 유지 PWM은 해제됐다. 팔 CH1/3/4/5는 이동 명령 없음/DISABLED이며 표시값 90은 부팅 추정값이다. 다음 코드 반영 시 위 최신 범위를 사용하고 특히 왼팔 Y에 기존 0/45/135/180 시험을 재사용하지 않는다.

## 2026-10-05 왼팔 Y축 135 -> 180 시험

* 사용자 지정: "왼팔은 안전범위가 180~ 135인것같아. 135에서 180으로 움직여봐". 이전 0..45는 왼팔의 검증된 범위가 아니며 최신 135..180도도 추정/시험 요청이다. 직전 0도 명령에서 큰 이동·충돌 위험을 안내한 뒤 사용자가 실행을 재지시했다. 일반 프로필/미설정 그룹 잠금은 변경하지 않았다.
* `TEST_LEFT_Y_PAIR,<135_or_180>,CONFIRM_FROM_LAST_ZERO`는 CH5만 부팅당 135/180 한 번씩 허용한다. 시작 0은 직전 완료 명령에 근거한 가정이며 실제 위치 피드백이 아니다. 135 준비 5000ms, 180 이동 3000ms 후 PWM 유지. PWM 50Hz/1000..2000us 변경 없음.
* Python 문법/가짜 PWM 검사, 소스 SHA-256 일치, Mega 컴파일(Flash 19158 / SRAM 4177바이트), 프로그램/Serial 비점유, 실제 업로드 검증/PING 성공. 135·180 각각 ACK/DONE, CH5=180 ENABLED/IDLE 및 종료 코드 0 확인. **실제 움직임/안전 범위는 사용자 확인 필요**다.
* 업로드로 이전 오른팔 Y=0 및 나머지 유지 PWM은 해제됐다. CH0~4는 DISABLED이며 상태의 90은 부팅 추정값이다. 다른 축 이동 명령, 전시 재시작, 자동 실행 변경, Git 작업 없음.

## 2026-10-05 양팔 Y축 0 -> 45 -> 0 시험

* 사용자 요청의 180도 Y축 이동은 이전 0..45 범위와 충돌 위험을 안내해 실행하지 않았다. 사용자가 0 -> 45 -> 0으로 변경해 CH3/CH5 고정 시험 `TEST_ARM_Y_PAIR,<0_or_45>,CONFIRM_0_45_0`을 추가했다. 부팅당 한 번의 0/45/0 순서만 허용하며 일반 그룹 잠금/기본 프로필/PWM 폭은 유지한다. 최초 출력은 요청한 0이고 위치 피드백이 없어 초기 이동 속도는 보장하지 않는다. 이후 이동은 양축 공통 시작으로 3000ms다.
* Python 문법/가짜 PWM 검사 및 소스 해시 일치, Mega 컴파일(Flash 18570 / SRAM 3948바이트), 프로그램·포트 비점유, 실제 업로드 검증/PING 성공. 세 단계 ACK/DONE과 CH3/CH5=0 ENABLED/IDLE, 종료 코드 0 확인. 실제 움직임은 사용자 확인 필요다.
* 업로드/Serial 리셋으로 이전 CH1=0·CH4=180 위치 유지 PWM은 해제되었다. 다른 CH0/1/2/4는 DISABLED이며 표시값 90은 부팅 추정값이지 이동 명령이 아니다. X축 재이동/유지 복구, 전시 재시작/자동 실행 변경/Git 작업은 하지 않았다.

## 2026-10-05 오른팔 X 0 / 왼팔 X 180 유지

* 사용자 요청으로 `TEST_ARM_X_HOLD,CONFIRM_FROM_ZERO` 고정 시험을 추가했다. CH1=0, CH4=180만 5000ms 공통 시작으로 명령하고 PWM을 유지한다. 시작 0은 직전 완료 명령에 근거한 가정이며 실물 측정값이 아니다. 부팅당 한 번, 확인 토큰 필수이며 일반 안전 범위/미설정 그룹 잠금/펄스 폭은 변경하지 않았다.
* Python 문법/가짜 PWM 검사, Mac/Pi SHA-256 일치, Mega 컴파일(Flash 17906 / SRAM 3727바이트), 프로그램/Serial 비점유 확인, 업로드 검증 및 PING 성공. ACK/DONE과 CH1=0·CH4=180 ENABLED/IDLE을 확인했다. 다른 축은 DISABLED, 전시 프로그램 재시작/Git 작업 없음. 실제 각도와 움직임은 사용자 확인 필요.

## 2026-10-05 양팔 X축 180 -> 0 동시 명령 시험

* 사용자 요청으로 CH1 오른팔 X(SG90 교체 확인)와 CH4 왼팔 X에만 고정 끝점 시험을 추가했다. `TEST_ARM_X_PAIR`는 명시적 확인 토큰, 5000..10000ms, 180 완료 후 0 순서, 부팅당 각 끝점 한 번을 요구한다. 기본 프로필/일반 팔 그룹 잠금/PWM 50Hz·1000..2000us는 그대로다. 최초 PWM의 저장 각도 90은 실물 측정값이 아니며 초기 급이동을 방지한다고 보장하지 않는다.
* Python 문법/가짜 PWM 검사 통과, Mac/Pi 소스 해시 일치, Mega 컴파일(Flash 17466, SRAM 3528바이트), 프로그램/포트 비점유 확인 후 업로드·검증과 PING/지원 확인을 완료했다. 두 축 공통 시작 시각으로 180(5000ms) -> 0(5000ms) 명령을 실행해 각 ACK/DONE과 최종 CH1/CH4=0 ENABLED/IDLE, 종료 코드 0을 확인했다. **실제 움직임/물리 각도는 사용자 확인 대기**다. CH0/2/3/5는 새 이동 명령 없음/DISABLED이며 상태의 90 표시는 부팅 추정값이다. 전시 재시작/자동 실행 변경/Git 작업은 하지 않았다.

## 2026-10-05 오른팔 X를 SG90으로 교체 후 180 -> 0 명령 시험

* 사용자 확인: Pi를 다시 켰고 기존 오른팔 X와 같은 CH1에 SG90을 연결했다. 오른팔 X만 SG90으로 교체됐으며 나머지 서보를 교체했다는 확인은 없다. 직전 오른팔 Y 45도 시험은 사용자가 실제 움직임을 확인했다. 기존 X는 여러 명령에 무반응/뚝뚝거림을 보고했으나 고장 원인은 확정하지 않았다.
* SSH/프로그램 없음/Serial 비점유/PING/시험 지원 확인 후 CH1에 180(5000ms) -> 0(10000ms)을 순차 명령했다. 각 ACK/DONE, 최종 CH1=0 ENABLED/IDLE 및 종료 코드 0 확인. 나머지 축은 이동 명령 없음/DISABLED다. **SG90의 실제 움직임과 회전 각도는 사용자 확인 대기**다. 펄스 폭/기본 프로필/펌웨어/Pi 전시 코드 변경, 재업로드, 프로그램 재시작은 하지 않았다. 기존 프로필의 180도 기본값은 새 SG90에서 검증된 내린 자세가 아니다.

## 2026-10-05 오른팔 X 무반응 보고 후 Y 45도 시험

* 사용자는 오른팔 X 90도 시험에서도 "아예 안 움직였는데"라고 보고하고 Y 45도를 요청했다. 실물 무반응 원인은 미확정이며 외부 서보 전원/배선 확인이 필요하다.
* 일반 CH3 그룹 잠금은 유지하고 고정 `TEST_RIGHT_Y_45,CONFIRM_45`만 추가했다. 임의 시작 0/90을 먼저 출력하지 않고 CH3에 45도 PWM만 설정한다. 부팅당 한 번이며 최초 이동 속도는 보장하지 않는다. DONE은 출력 명령 처리 완료이지 물리 도달 확인이 아니다.
* Python 문법/가짜 PWM 검사 통과 및 Mac/Pi 소스 SHA-256 일치 후 Mega 컴파일(Flash 16582, SRAM 3180바이트), 프로그램/포트 비점유 확인, 실제 업로드/검증, PING/지원 응답 확인을 완료했다. CH3=45 ACK/DONE, STATUS ENABLED/IDLE 및 종료 코드 0을 확인했다. **실제 움직임은 사용자 확인 대기**다. 다른 축에 이동 명령 없음; 업로드로 CH0/1/2/4/5의 유지 출력은 DISABLED다. PWM 50Hz/1000..2000us, 기본 프로필, Pi 전시/자동 실행은 변경하지 않았다.

## 2026-10-05 최신 각도 시험: 오른팔 X 0도, 고개·정수리 90도

* 사용자 요청으로 프로그램/Serial 비점유 확인 후 CH1=0(10000ms), CH0=90(5000ms), CH2=90(5000ms) 순차 명령을 실행했다. PING, 각 ACK/DONE, 최종 세 축 ENABLED/IDLE 및 종료 코드 0을 확인했다. CH3/4/5는 명령 없음/DISABLED다. **실제 움직임은 사용자 확인 대기**다. 아래 180/45/45 응답은 직전 시험이다. 기본 프로필/펌웨어 변경, 재업로드, 전시 재시작은 하지 않았다. 오른팔 0도는 일반 135..180 범위와 구분되는 명시적 시험 명령이다.

## 2026-10-05 재부팅 후 세 축 기본 자세 재시험, 실물 확인 대기

* 최신 재시험: 사용자가 Pi를 껐다 켠 뒤 다시 요청했다. SSH/실행 프로그램 없음/Serial 비점유 확인 후 기존 독립 시험만 실행했다. CH0=45(5000ms), CH1=180(10000ms), CH2=45(5000ms) 각각 ACK/DONE, 최종 ENABLED/IDLE, 종료 코드 0. CH3/4/5는 명령 없음/DISABLED다. 재업로드·프로그램 재시작·코드 변경은 하지 않았다. **실제 움직임은 사용자 확인 대기이며, 아래 무반응 보고는 직전 시험 결과다.**

* 사용자 관찰: 직전 0도 시험에서 오른팔 X는 팔을 번쩍 올린 상태다. "오른팔 x축은 기본상태가 180도로 두고, 왼팔과 반대로 움직여야해". 혼을 돌려 다시 장착하는 방법은 사용하지 않는다. 고개/정수리의 서보 0도는 실제 오른쪽 45도이며 요청 범위는 0..90도, 정면 기본 명령은 45도다.
* Mac 통합 프로필과 Arduino에 CH0 고개 0..90/기본 45, CH2 정수리 0..90/기본 45를 반영했다. CH1 오른팔 X는 기본 180, 상대 0 -> 실제 180, 상대 +45 -> 실제 135로 감소 방향을 기록했다. 이전 상대 -45 요청은 실제 225가 되어 불가능하므로 유효 상대 범위는 우선 0..45/실제 135..180으로 제한했다. 범위 전체의 기구 안전 검증이나 왼팔 기준 확인을 완료한 것은 아니다. 오른팔 Y 및 왼팔 두 축은 미설정/잠금 유지다.
* 독립 `test_home_pose.py`와 펌웨어 `TEST_HOME_POSE`를 추가했다. CH0/1/2의 고정 기본값만 허용하며 `CONFIRM_FROM_0`, 출력 비활성인 신규 채널, 부팅당 채널별 한 번 조건을 검사한다. 시작값 0은 직전 시험/사용자 관찰에 근거한 명시적 가정이지 위치 피드백이 아니다. 부팅 시 자동 이동을 추가하지 않았다.
* Python 문법 통과, 단위 검사 56개 중 52개 통과/기존 CAD 검사 4개(`ezdxf` 없음) 건너뜀, 가짜 Serial/PWM 검사 통과. Mac/Pi 소스 SHA-256 일치와 Mega 컴파일 성공: Flash 16170바이트(6%), SRAM 2927바이트(35%), 남은 SRAM 5265바이트.
* 프로그램 중지/Serial 비점유 확인 후 사용자 요청과 기존 위임에 따라 새 펌웨어를 실제 Mega에 업로드하고 `--verify` 성공했다. PING/시험 지원 확인 후 **CH0 0 -> 45(5000ms), CH1 0 -> 180(10000ms), CH2 0 -> 45(5000ms)** 순차 실행, 각각 ACK/DONE과 마지막 상태 및 종료 코드 0을 확인했다.
* 마지막 `STATUS_GROUP`: CH0=45, CH1=180, CH2=45 모두 ENABLED/IDLE. **CH3/4/5는 명령을 보내지 않았고 DISABLED/IDLE**다. 이 세 축에 표시되는 소프트웨어 값 90은 부팅 추정값이며 실제 90도로 움직였다는 뜻이 아니다. 업로드 리셋으로 이 축의 직전 0도 유지 PWM은 해제됐으므로 실제 자세 유지도 보장하지 않는다.
* 사용자 실물 보고: **"엥 움직였다고? 아무것도 안움직였어"**. 위 ACK/DONE/STATUS는 펌웨어의 소프트웨어 응답일 뿐 실제 이동 성공이 아니다. 실제 기본 자세는 미확인이고 세 축 모두 무반응 원인을 점검해야 한다. 추가 이동/재업로드/Serial 재접속은 하지 않는다. 서보 외부 전원, 트리거 보드 출력, PCA9685 V+/GND 및 신호 경로부터 확인한다. 전원 부재나 기판 고장으로 원인을 단정하지 않는다.
* Pi 기존 `main.py`/`config.py`와 자동 실행은 변경하지 않았고 전시 프로그램은 여전히 중지 상태다. **세 버튼은 비활성이고, 기존 3축 프로그램의 90도 팔 기본값/150도 정수리 목표는 새 펌웨어와 호환되지 않는다. 재부팅/예전 전시 재시작 금지.** 실물 프로그램에는 독립 시험 파일만 임시 폴더에 복사했다. 통합 실행부 전체 배포/자동 실행 전환/Git commit/push는 하지 않았다.
* PWM 50Hz/1000..2000us는 그대로다. 다음: 무반응 원인과 외부 서보 전원/배선 확인 -> 사용자 요청 후 안전한 단일 축 재시험 -> 기본 자세 실물 확인 -> CH3/4/5 기준 및 몸짓 목표 -> 기구·전원 검증 -> 통합 배포/버튼 복구. 아래 6개 0도 기록은 과거 상태다.

## 2026-10-05 실제 6개 서보 0도 시험 완료와 업로드 권한 갱신

* 사용자 원문: **"업로드 승인. 앞으로 그냥 바로 너가 업로드 해"**. 이번 0도 시험 업로드 승인 및 앞으로 요청한 이 프로젝트의 코드 변경에 필요한 Arduino 업로드를 매번 재승인 없이 진행하라는 지시로 기록했다. `AGENTS.md`를 갱신했다. 요청하지 않은 실물 시험, PWM 펄스 폭 변경, Git push나 Pi 자동 실행 변경을 자동 승인한 뜻은 아니다.
* 소스/공유 시험 실행부/0도 진입점의 Mac/Pi SHA-256 일치, Python 문법과 Mega 컴파일을 재확인했다. Flash 15462바이트(6%), SRAM 2632바이트(32%). Serial 포트는 by-id -> ttyACM -> ttyUSB 우선순위로 탐색했고 기존 전시 프로그램 중지/포트 비점유를 확인했다.
* 0도 고정 시험을 포함한 펌웨어를 연결된 Mega에 실제 업로드하고 `--verify`를 성공했다. Pi 전시 실행 코드와 자동 실행 설정은 변경하지 않았으며 독립 시험 파일 2개만 `~/capstone-robot-build/zero_0_test/`에 복사했다.
* 실제 PING ACK, 0도 시험 지원 응답, 부팅 출력 비활성 메시지를 확인한 뒤 CH0~CH5 순서로 `TEST_ZERO_0,<channel>,5000,CONFIRM_0`을 실행했다. 각 채널 ACK/DONE, 채널 간 0.5초 대기, 마지막 `STATUS_GROUP`에서 **6개 모두 `0:ENABLED:IDLE`**, 시험 종료 코드 0을 확인했다.
* 이는 **0도 명령 완료와 PWM 출력 상태** 확인이며 실제 물리 각도나 내린 자세/충돌 부재의 측정은 아니다. 현재 각 팔 자세에 대한 사용자 실물 확인은 대기 중이다. 상대 0도의 실제 기준값이나 기본 자세를 임의로 저장하지 않았다.
* 시험 후 전시/시험 프로세스가 없음을 확인했다. 마지막 확인된 출력은 0도 유지, Pi는 켜져 있으며 전시 프로그램은 중지 상태다. **전시·카메라·전원 OFF 버튼은 비활성이다.** 기존 자동 실행 등록은 남아 있으므로 캘리브레이션 전 재부팅/전시 재시작을 하지 않는다. 확인 과정에서 Serial을 다시 열거나 추가 이동을 하지 않았다.
* PWM 50Hz/1000..2000us, 기존 전시 제한, 미확정 팔 그룹 잠금은 유지한다. 고정 시험 명령은 전시 제한과 별개이며 부팅당 한 번 제한을 피하기 위한 자동 리셋/재실행은 하지 않는다. 전시 재시작/통합 자동 실행 전환/Git commit/push는 하지 않았다.
* 다음: 사용자가 현재 0도 자세와 팔 축 방향을 확인 -> 실제 내린 자세에 해당하는 서보 숫자 및 상대 안전 범위 변환 -> 최종 기본/동작 자세 설정 -> 검사 후 필요한 펌웨어 업로드와 요청된 실물 검증. 앞으로 업로드는 재승인 대신 검사/포트/프로그램 중지/검증/PING/결과 보고 절차를 유지한다.

## 2026-10-05 6개 서보 0도 시험 준비, 업로드 승인 대기

아래는 이번 승인·실행 전 준비 기록이다. 최신 완료 결과와 업로드 권한은 위 절을 따른다.

* 사용자 요청: "제한 풀고 전부 0도로 맞춰. 기존 코드는 지금이랑 상당히 다를텐데". 기존 오른팔/정수리 각도 제한은 과거 구성의 소프트웨어 설정이며 현재 기구의 검증된 한계로 단정하지 않는다. 요청은 실제 서보 명령 0도 시험이며 상대 0도나 내린 자세 확정이 아니다.
* 충돌/과부하 위험 안내 후 Mac `.ino`에 `TEST_ZERO_0`/`TEST_ZERO_CAPS`를 추가했다. 0도 고정 시험은 기존 전시 범위/팔 그룹 잠금과 독립적으로 한 채널씩 허용한다. 명시적 `CONFIRM_0`, 부팅당 채널별 한 번, 유효 기간/채널/중복 동작 검사와 STOP 처리는 유지한다. 임의 각도 전체 허용이나 자동 이동을 추가하지 않았다. PWM 50Hz/1000..2000us와 부팅 출력 비활성을 유지한다.
* 독립 진입점 `test_servo_zero_0.py`는 공유 시험 실행부를 사용한다. `--confirm-physical-0`가 없으면 Serial을 열기 전에 거부한다. 승인 후 CH0~CH5 순서, 채널별 5000ms, 완료 응답 확인 후 0.5초 간격으로 실행하도록 준비했다. 기본 자세/안전 범위를 저장하거나 전시를 재시작하지 않는다.
* 검사: Python 문법 통과, 전체 53개 중 49개 통과/기존 CAD 4개(`ezdxf` 없음) 건너뜀, 가짜 PWM/Serial 검사 통과. 90도 시험의 호환성과 0도 순차 보간/ACK/DONE/재실행 거부, 기존 전시 제한과 PWM 유지도 확인했다.
* Pi 임시 빌드 폴더에 소스만 복사하고 Mac/Pi SHA-256 일치 후 **컴파일만** 성공했다. Mega용 Flash 15462바이트(6%), SRAM 2632바이트(32%), 남은 SRAM 5560바이트. 0도용 바이너리는 `~/capstone-robot-build/zero_0_test/binaries/`이며 이전 90도 시험 바이너리와 구분한다.
* **0도 펌웨어 업로드와 실제 0도 이동은 하지 않았다.** 실제 Mega는 직전 승인된 90도 시험 펌웨어다. 이번 작업에서는 Serial을 열지 않았으므로 마지막 확인된 90도 PWM 상태에 새 이동/리셋을 가하지 않았다. 현재 실물 자세를 새로 센서 측정했다는 뜻은 아니다.
* 다음: 이번 0도 시험에 대해 사용자가 `Arduino 업로드 승인`을 명시 -> 프로그램/포트 소유 확인 -> 새 펌웨어 업로드/검증 -> 독립 시험 파일 준비 -> PING/지원 확인 -> 사용자 요청한 6개 순차 0도 시험. 첫 PWM 때 소프트웨어의 90도 추정값이 출력될 수 있어 5000ms가 모든 물리적 급이동을 방지하지는 않는다.
* 통합 전시 코드는 미배포, 기존 전시 프로그램은 직전 시험에서 중지했고 재시작/자동 실행 변경/Git commit/push는 하지 않았다. 기존 버튼/재부팅 관련 주의는 아래 직전 실제 시험 기록을 따른다.

## 2026-10-05 승인된 6개 서보 실제 90도 시험 완료

* 사용자 요청은 상대 각도가 아닌 실제 서보 명령 90도에 6개 모두 맞추는 것이다. 충돌/과부하와 첫 PWM 급이동 위험을 경고했고 사용자가 계속 실행을 요청한 뒤 **`Arduino 업로드 승인`**을 명시했다. 혼 분리와 기구 안전이 확인됐다는 의미는 아니다.
* `.ino`에 `TEST_CENTER_90`/`TEST_CENTER_CAPS`/`STATUS_GROUP`을 추가했다. 명시적인 `CONFIRM_90`을 포함한 90도 고정 시험만 채널별 부팅당 한 번 허용한다. 기존 그룹의 미확정 팔 범위/초기 잠금, PWM 50Hz/1000..2000us, 실제 초기 자세 프로필은 유지한다.
* 독립 `test_servo_center_90.py`를 추가했다. 기본 실행은 거부하며 `--confirm-physical-90`에서만 Serial 소유 확인, PING, 시험 지원 확인, 한 채널씩 ACK/DONE 대기와 마지막 6축 상태 확인을 수행한다. 실패/중단은 가능한 경우 STOP, 자동 복귀/재시작은 하지 않는다.
* Python 문법 통과, 전체 49개 중 45개 통과/기존 CAD 4개(`ezdxf` 없음) 건너뜀. 가짜 Serial/PWM 검사도 통과했다. Mac/Pi 소스 SHA-256 일치 후 Mega용 컴파일 성공: Flash 15104바이트(5%), SRAM 2500바이트(30%), 남은 SRAM 5692바이트.
* Pi 기존 `main.py` 프로세스를 중지하고 Serial이 비어 있음을 확인한 뒤, 사용자가 승인한 Mega 업로드를 `--verify`로 성공했다. 시험 중 실제 `ACK,PING`과 부팅 출력 비활성 메시지를 확인했다. Pi의 전시 코드/기본 각도/자동 실행 파일은 변경하지 않았다. 시험 파일은 실행 코드 폴더가 아닌 임시 빌드 아래 `center_90_test/`에 복사했다.
* 실제 CH0~CH5 순서로 한 개씩 `TEST_CENTER_90,<channel>,3000,CONFIRM_90`을 실행했다. 각 채널 ACK/DONE 확인, 마지막 `STATUS_GROUP`은 **6채널 모두 `90:ENABLED:IDLE`**, 시험 종료 코드 0이다. 3000ms는 소프트웨어 대기/이동 기간이며 첫 출력 시 실제 서보의 이동 속도를 보장하지 않는다.
* 이것은 **90도 명령 완료 및 PWM 상태** 확인이다. 실제 각도 피드백이나 팔을 내린 자세/기구 간섭의 검증이 아니다. 사용자 실물 관찰을 기다린다. 오른팔의 상대 0도와 실제 명령값 관계는 아직 미확정이며 기본값으로 저장하지 않았다.
* 시험 후 전시/시험 프로세스가 남아 있지 않음을 확인했다. PWM은 90도 출력 유지, Pi는 켜져 있고 전시 프로그램은 중지 상태다. **전시·카메라·전원 OFF 버튼은 지금 비활성이다.** 기존 데스크톱 자동 실행 등록은 남아 있어 Pi 재부팅/다음 로그인 시 예전 `main.py`가 다시 시작할 수 있다. 새 팔 캘리브레이션 전 재부팅/전시 실행을 하지 않는다.
* 다음: 사용자가 현재 90도에서 각 팔 자세를 확인 -> 실제 내린 자세 기준값/방향과 안전 범위 결정 -> Pi/Arduino 설정 일치 -> 별도 요청 후 배포/통합 시험. 이번 승인으로 이후 다른 펌웨어 업로드가 자동 승인되는 것은 아니다. Git commit/push와 통합 전시 자동 실행 전환은 하지 않았다.

## 2026-10-05 오른팔 내린 자세와 상대 각도

* 사용자 관찰: 로봇 자신의 오른팔 X축이 팔을 번쩍 들어 올리고 있다. 실제 명령이 180도인지, 현재 기구에서 어느 숫자가 내린 자세인지 확인되지 않았다.
* 사용자 확인: **"내린 자세가 상대 0도, 실제 명령값은 모름"**. 오른팔 X축의 요청 안전 범위는 상대 -45..45도, Y축은 상대 0..45도다. Y는 사용자가 말한 옆으로 들어 올리는 축이며 실제 채널/기구 방향은 개별 확인이 필요하다. 좌측 팔에 동일 범위를 임의 적용하지 않는다.
* Mac 통합 프로필에 오른팔의 상대 기본 자세 0도/범위를 추가했다. 실제 서보 0..180도 값과 구분하고 기준값(`servo_zero`) 및 방향(`direction`)이 없으면 변환과 실물 실행을 거부한다. 측정 후 변환된 초기/범위는 Arduino 설정과도 일치해야 한다.
* 실제 서보의 초기 값과 몸짓 목표는 여전히 미확정이다. **로컬 상대 기준만 반영했으며 실제 팔을 내린 결과가 아니다.** 기존 `main.py`/`config.py`의 한 축 전시 설정 90->180->90은 변경하지 않았다. 캘리브레이션 전 기존 전시 버튼으로 새 팔을 시험하지 않는다.
* 다음: 서보 전원을 분리하고 안전하게 기구/혼을 정렬한 뒤 개별 기준값과 증가 방향을 확인한다. 이미 올라간 팔을 큰 각도 명령으로 즉시 내리지 않는다. 작은 단계의 현장 캘리브레이션 절차와 실행 여부는 별도로 정한다.
* 검사: Python 문법 통과, 전체 45개 중 41개 통과/기존 CAD 검사 4개(`ezdxf` 없음) 건너뜀. 상대 기준값 누락, 음수의 직접 사용, 불가능한 변환 및 초기 값 불일치 거부를 확인했다. 실물 안전 검증은 아니다.
* 이번 변경에서 Pi 접속/배포/재시작, 실제 서보 시험, Arduino 변경/컴파일/업로드, Git commit/push는 하지 않았다.

## 2026-10-05 로봇 동작 통합 코드와 컴파일

* 사용자 요청: 로봇이 완성된 상태이므로 계획 후 코딩 시작. 범위 확인 답변은 **로봇 동작 통합만**, 배선은 이전 표대로 했다는 것이다. 앱은 제외하며 새 팔 초기/안전/몸짓 각도와 전원 계측은 확인되지 않았다.
* 별도 `integrated_demo.py` 실행부, 상위 타임라인, 하드웨어 단일 소유, 6축 프로필/검증을 추가했다. 승인된 눈 표현과 두 WAV를 유지하며 고개/오른팔 인사 -> 왼팔 초대 -> 전체 복귀/깜박임으로 구성한다. 가상 시연은 약 9.4초, 기존 `main.py` 기본 동작은 변경하지 않았다.
* Arduino 소스와 Python 통신에 `CAPS`/`MOVE_GROUP`을 추가했다. 전체 대상 검증 후 공통 시작 시각으로 이동하며 STOP/DISABLE은 6채널에 적용된다. 팔 4축의 그룹 범위/초기 값은 `-1`로 잠겨 있고 Pi 값은 `null`이다. 기존 팔의 180도를 새 기구에 복사하지 않았다. PWM 값은 유지한다.
* 프로필/전원 확인이 빠지면 USB/GPIO를 열기 전에 실물 실행을 거부한다. 펌웨어의 범위/초기 값과 Pi 설정이 다르거나 기존 프로그램이 Serial을 사용하면 거부한다. 중복 버튼 입력은 쌓지 않으며 오류/중단 후 자동 복귀와 자동 재개는 하지 않는다.
* 검사: Python 문법 통과, 전체 42개 중 38개 통과/기존 CAD 변환 4개(`ezdxf` 없음) 건너뜀, 가짜 PWM/Serial 검사 통과, 가상 demo/camera/startup 확인. 실물 실행 거부 조건도 Mac에서 확인했다. 실제 서보/OLED 시험은 아니다.
* 지정된 Pi 임시 빌드 폴더에 `.ino` 하나만 복사하여 Mega용 컴파일 성공: Flash 14192바이트(5%), SRAM 2143바이트(26%). **연결된 Mega에는 업로드하지 않았다.**
* 읽기 전용 Pi 확인: SSH는 Mac 키체인으로 성공, 기존 `main.py`가 실행 중, SPI 장치 두 개와 USB Serial 장치를 확인했다. GPIO4/18을 쓰는 별도 overlay는 설정 파일에서 확인되지 않았고 별도 OLED 시험 폴더의 DC/RST는 이전 16/26 BCM 설정이었다. 코드/실물 배선 동기화가 필요하다.
* 실행 환경 확인: 시스템 Python에는 `luma`가 없지만 기존 OLED 가상환경에는 `serial`/`gpiozero`/Pillow/`luma`가 모두 있다. 패키지 설치는 하지 않았다. 향후 통합 시작 스크립트는 이 환경 또는 동일 의존성을 갖춘 환경으로 별도 전환해야 한다.
* 다음: 새 팔 4축의 초기/안전/몸짓 각도와 전원 검증 -> Pi/Arduino 프로필 일치 -> 별도 업로드 승인 -> 사용자 지시 후 배포/실물 시험/자동 실행 전환. 캘리브레이션 전 기존 전시 버튼으로 새 팔을 시험하지 않는다.
* [구현·안전·검사·전환 절차](19_ROBOT_INTEGRATION.md). Pi 실행 코드 배포/프로그램 재시작/자동 실행 변경, Arduino 업로드, 실제 동작, Git commit/push는 하지 않았다.

## 2026-10-05 두 번째 OLED의 낮은 번호 핀 배치

* 사용자 요청: CE1의 DC/RST 36/37번과 GND 30번을 낮은 번호로 옮긴다. 새 기준은 **DC 물리 7번(BCM4), RST 물리 12번(BCM18), GND 물리 9번**이다. 정면 관찰자 기준 CE1은 오른쪽 눈으로 사용하는 계획이다.
* Mac의 `oled_controller.py`에서 CE1 DC/RST만 BCM4/18로 변경하고 핀 배정 단위 검사와 배선 문서를 함께 갱신했다. GND는 코드 설정 대상이 아니다.
* `bash scripts/check_python.sh` 문법 검사와 하드웨어 없는 OLED 단위 검사 17개를 통과했다. 실제 Pi 출력 검증은 아니다.
* CE0, 공유 MOSI/SCLK, CS, VCC, 버튼/LED, 눈구멍 CAD + 3픽셀 확장, 눈동자 모양/밝기/애니메이션, 기본 시험 15초는 유지한다. 전시 및 Arduino 코드는 변경하지 않았다.
* **Pi 배포, 실제 재배선 완료, 새 핀으로 실물 시험은 미완료/확인 필요다.** Pi에 남은 기존 DC/RST 코드로 새 배선을 시험하지 않는다. 배포 전 GPIO4/18의 별도 OS 기능 사용 여부를 확인한다.
* 다음 작업: Pi 안전 종료 후 Pi와 서보 전원 분리 -> CE1의 세 선 재배선 -> 사용자 지시 후 Pi OLED 시험 폴더에 새 코드 반영 -> 15초 OLED 전용 시험.
* Pi 접속/배포/재시작, Arduino 컴파일/업로드, 실제 OLED/서보 시험, Git commit/push는 이번 작업에서 실행하지 않았다.

## 2026-10-05 전시 앱 에셋 준비 목록

* 사용자 요청에 따라 [에셋 준비 목록](18_ASSET_CHECKLIST.md)을 작성했다. 최소 체험용 원본은 현재 CUVO 대표 이미지 1장과 사용 가능한 예시 영상 1개를 우선 준비하는 안이다.
* 저장소에서 WAV 두 개, 눈 PNG/GIF, CAD와 눈 설정을 확인했다. 제품 대표 이미지, 확정 로고, 예시 영상, 폰트는 저장소에 아직 등록되지 않았다. 외부 폴더나 대화 첨부 자료의 부재를 뜻하지 않는다.
* 썸네일/영상 정보는 원본 영상에서 파생하고 공통 아이콘은 구현 시 구성한다. 로고가 없으면 CUVO 텍스트를 사용한다. 현재 승인된 눈을 다시 디자인하지 않는다.
* 관람자 실제 기록을 수집하지 않는 범위를 유지한다. 예시 자료의 사용권과 Public GitHub 공개 가능 여부는 별도로 확인한다.
* 목록과 관련 문서만 갱신했다. 실제 에셋 제작, 코드 수정, 로봇 접속/배포, Arduino 작업, Git commit/push는 하지 않았다.

## 2026-10-05 전시 체험과 휴대폰 앱 계획

* 사용자 요청: `DESIGN.md`를 참고하되 그대로 따르지 않고 전시 로봇 동작과 앱 메뉴/흐름/기능을 계획한다.
* 사용자 확정 범위: 앱은 **관람자가 직접 조작하는 체험용**, 기록은 **예시 기록**이다. 이번 계획은 실제 관람자 촬영/저장을 기본 시연에 포함하지 않는다.
* [전시 동작 및 앱 계획](17_EXHIBITION_AND_APP_PLAN.md)을 작성했다. 홈 / 기록 / 기기와 별도 전시 운영 화면, 약 15초 놀이, 검증된 프리셋, 중복 시작/중단/연결 끊김 정책을 제안했다. 메뉴와 시간은 아직 승인되거나 구현된 값이 아니다.
* WAV 메타데이터 확인: 첫 파일 약 1.437초, 두 번째 약 1.907초. 현재 코드의 시연은 계산상 약 6초이며 약 15초 체험에는 새로운 대기/눈 타임라인이 필요하다.
* 앱, 상위 통합 제어, 6축 팔 자세, 로컬망/권한, 예시 클립 준비는 미구현/확인 필요다. 전원과 기구 안전 확인을 먼저 진행한다.
* 현재 제품 맥락과 자료의 발달검진/대여 서비스 콘셉트를 구분해 반영했으며 임상 효과나 실제 의료기관 전달 기능을 확정하지 않았다.
* 문서만 변경했다. 코드, 실제 Pi, Arduino, 자동 실행, Git commit/push는 변경하거나 실행하지 않았다.

## 2026-10-05 CUVO 6축 구성 및 전체 배선 계획

* 사용자 지정 하드웨어: 고개 회전 1개, 카메라가 달린 정수리 회전 1개, 양팔 어깨 X/Y 각 1개로 **SG92R 총 6개**. 이전 오른팔 MG996R 표기는 과거 구성이다.
* 기존 Raspberry Pi 4B / USB 연결 Mega / PCA9685 구조와 1번 SH1107 OLED 두 장을 유지한다. 카메라는 리본 케이블 연결 후 사용자가 영상을 확인했다. 정확한 센서 모델은 이 배선 계획에서 확정하지 않는다.
* 사용자 제공 전원 사양: 트리거 모듈 최대 5A 및 5/9/12/15/20V 선택, 40W 어댑터 두 포트에 각각 5V 3A / 9V 2.22A와 5V 3A / 9V 2A. 실제 출력 및 동시 부하 검증은 미완료다.
* [전체 배선 계획](16_FULL_SYSTEM_WIRING_PLAN.md)을 작성했다. CH0 고개 / CH1 오른팔 기존 축 / CH2 정수리를 유지하고 CH3 오른팔 추가 축 / CH4~5 왼팔 두 축을 제안한다. X/Y 역할 이름은 기구 확인 전 임시이며 최종 배선 확정이나 구현 완료가 아니다.
* 현재 Arduino/Python은 3채널 제어다. 새 축의 명령, 안전 범위, 중립 자세, 양팔 동작과 눈/음성 연동은 구현 전이다. 기존 오른팔 각도를 새 네 축에 자동 적용하지 않는다.
* 전원 위험: 모듈의 최대 5A는 어댑터 공급 능력이 아니다. 현재 포트의 5V 출력은 3A/15W이며 6개 동시 동작에 충분함이 확인되지 않았다. SG92R 제조사 4.8V 사양과 보유 제품의 5V 허용 여부를 구분한다.
* 다음 작업: 전원 전압/용량 확정 -> 어깨 축 정의/기구 하중 확인 -> 6축 코드와 개별 안전 자세 준비 -> 별도 업로드 승인 -> 작은 각도부터 단계적 부하 확인.
* 기존 눈구멍 CAD + 3픽셀 확장과 15초 OLED 시험 기준은 유지한다.
* 이번 작업은 문서 작성만 수행했다. 코드 변경, Pi 접속/배포/재시작, Arduino 컴파일/업로드, 서보 시험, Git commit/push는 하지 않았다.

## 2026-09-29 눈구멍 표시 영역 3픽셀 확장

* 사용자 요청: "눈구멍을 아주 살짝만 크게", "대충 3픽셀정도 크게". 경계를 바깥쪽으로 약 3픽셀씩 넓히는 것으로 반영했다. 전체 폭만 3픽셀 늘리는 설정은 아니다.
* `aperture_expand_px=3`으로 원형 이웃 마스크 확장. 원본 DXF/눈구멍 좌표, 눈동자 크기/두께, 밝기, 좌우 28픽셀 이동과 복귀 깜박임은 유지한다. 화면 밖으로 넘어간 부분은 잘리고, 오른쪽은 왼쪽 확장 마스크의 수평 대칭이다.
* 값을 0으로 바꾸면 원본 CAD 마스크로 돌아간다. 실제 외장 구멍 자체가 바뀌는 것은 아니다.
* Python 문법 및 21개 단위 검사 통과. OLED 전용 폴더의 렌더러/설정 두 파일만 반영했고 Mac/Pi SHA-256 일치, Pi 문법/렌더링 검사를 확인했다.
* 3픽셀 확장 상태의 Pi 시험: 15.0초, 322프레임, 평균 21.4fps, 종료 코드 0. 두 화면을 지우고 남은 시험 프로세스가 없음을 확인했다. 전시/서보/Arduino/자동 실행과 Git commit/push는 변경하거나 실행하지 않았다.
* 사용자 실물 확인: "눈구멍 지금 완벽해". 원본 CAD + 바깥쪽 3픽셀 확장을 현재 승인된 눈구멍 기준으로 유지한다. 별도 요청 없이 매핑을 다시 바꾸지 않는다. 이는 사용자 육안 확인이며 치수 계측 결과는 아니다.
* 사용자 요청으로 Pi 안전 종료 명령을 실행했고 종료 코드 0을 확인했다. 다음 시험 전 Pi 전원을 켜고 SSH 연결부터 확인한다.

## 2026-09-29 원본 CAD 눈구멍과 복귀 깜박임

이 절은 CAD 도입 기록이다. 이후 눈구멍 3픽셀 확장 상태는 맨 위 절을 따른다. 아래의 타원 근사, 38픽셀 이동, 깜박임 없는 시선 시험은 과거 기록이다.

* 사용자 확인: 이전 시선 이동 시험은 잘 됐다. 후속 요청은 눈동자 폭의 0.3배 이동과 정면 복귀 후 깜박임이다.
* 용어: 눈동자는 흰 타원 그래픽, 눈구멍은 고정 표시 허용 영역이다. 눈동자는 유지하고 눈구멍만 원본 CAD 윤곽으로 바꿨다.
* 사용자 제공 `Sketch20.dxf`를 `docs/assets/cad_exports/eye_opening_left.dxf`에 보존했다. 기울어진 V.A. 좌표계를 바로잡아 비대칭 곡선을 103점으로 변환했다. 정면 왼쪽 아래가 더 넓은 윤곽을 반영하며 오른쪽은 좌우 대칭이다.
* 눈동자 94x119픽셀/선 10픽셀/밝기 255 유지. 좌우 이동은 각각 28픽셀, 이동 0.2초/유지 0.8초/복귀 0.2초/깜박임 0.42초다. 각 방향 전 정면 대기 1초, 전체 주기 5.24초다.
* 눈구멍 JSON, 그래픽, 시간 기반 동작, OLED 출력, 시험 실행을 분리했다. 눈동자를 옮긴 후 마스크를 한 번만 적용한다. 이후 매핑만 바꿔도 동작 코드와 눈동자 모양은 유지된다.
* 로컬 Python/셸 문법 검사와 19개 단위 검사 통과. Pi의 기존 OLED 시험 파일을 백업하고 독립 시험 폴더에 6개 파일만 반영했다. Mac/Pi SHA-256 일치, Pi 문법 검사와 하드웨어 없는 751개 시점 렌더링 검사를 통과했다.
* Pi `--gaze` 시험 완료: 15.0초, 두 눈 묶음 324프레임, 평균 21.6fps, 종료 코드 0. 화면 지우기 후 남은 OLED 시험 프로세스가 없음을 확인했다. 새 눈구멍과 복귀 깜박임의 사용자 육안 평가는 대기 중이다.
* 미확정: A.A.가 V.A. 중앙이라는 가정 및 실제 장착 오차. 원본 CAD를 반영했어도 실물과의 완전한 일치까지 확인된 것은 아니다.
* 다음 작업: 사용자 관찰로 특히 정면 왼쪽 아래 가림과 반대쪽 대칭을 확인한다. 같은 시험 재실행은 `bash ~/cuvo_oled_test/run_oled_pair_test.sh --gaze`이며 기본 15초다. 버튼/앱/카메라/서보의 상위 통합 제어는 후속 작업이며 아직 구현하지 않았다.
* [매핑 및 연동 구조](15_EYE_MAPPING_AND_CONTROL.md), [배선 및 시험](14_DUAL_OLED_EYES.md). 전시/Arduino/자동 실행 변경과 Git commit/push는 하지 않는다.

## 2026-09-29 좌우 시선 이동 추가

* 사용자 요청에 따라 현재 타원 크기는 유지하고 폭의 0.4배인 좌우 각각 38픽셀을 이동시키는 `--gaze` 시험 옵션을 추가했다. 기존 기본 깜박임 시험은 유지한다.
* 정면 1초 -> 한쪽 이동 0.2초 -> 바라보기 0.8초 -> 정면 복귀 0.2초 후 반대쪽도 반복한다. 시험은 15초이며, 시선 이동 관찰을 위해 이 옵션에서는 깜박이지 않는다.
* 두 눈은 정면 관찰자 기준 같은 방향으로 이동한다. 94x119픽셀 타원, 10픽셀 선, 밝기 255를 유지한다. 눈구멍 밖은 고정 마스크로 가려지므로 끝 위치에서 한쪽 곡선만 남을 수 있다. 임의 축소는 하지 않았다.
* 문법/10개 단위 검사 통과 후 OLED 시험 코드와 설정 두 파일만 Pi에 반영했다. Mac/Pi 해시 일치와 Pi 문법 검사를 확인했다.
* Pi 시선 이동 시험은 15.0초, 322프레임, 평균 21.4fps로 종료 코드 0을 확인했고 두 화면을 지웠다. 실제 보이는 이동과 가림에 대한 사용자 평가는 대기 중이다.
* 재실행: `bash ~/cuvo_oled_test/run_oled_pair_test.sh --gaze`. 자세한 설정과 미리보기는 [두 눈 시험 문서](14_DUAL_OLED_EYES.md#좌우-시선-이동-시험)를 따른다.
* 실물에서 이동량과 가려지는 모습이 적절한지 사용자 확인이 필요하다. 서보/전시/Arduino/자동 실행과 Git commit/push는 변경하거나 실행하지 않았다.

## 2026-09-29 SH1107 두 눈 정렬과 깜박임

이 절은 초기 두 눈 시험 기록이다. 현재 OLED 상태는 맨 위 절을 따른다.

* 사용자 확인: 두 장 모두 1번 SH1107 128x128 제품. 도면은 정면에서 본 왼쪽 눈이며 오른쪽은 좌우 대칭, 두 패널 헤더는 위쪽이다.
* 새 독립 시험 `test_oled_pair.py`, `oled_pair_calibration.json`, `run_oled_pair_test.sh`와 7개 단위 검사를 추가했다. 기존 승인된 3번 단독 시험 파일은 그대로 보존했다.
* V.A. 28.86 mm와 상품 도면의 A.A. 26.86 mm를 구분한다. 중앙 A.A. 가정과 타원 근사, 0.8 mm 안쪽 여유를 사용한다. 정확한 CAD 윤곽 재현은 아니다.
* 최대 밝기 설정 255, 10픽셀 연속선, 3.42초 주기의 동시 깜박임. 사용자 후속 요청 "지금의 1.7배정도"에 따라 6픽셀에서 10픽셀(약 1.67배)로 두껍게 했다. 외곽 위치와 깜박임 시간은 유지한다. CE0를 정면 왼쪽으로 가정하며 `--swap-displays`로 바꿀 수 있다.
* Mac 문법/셸 검사와 7개 단위 검사 통과. Pi 별도 OLED 시험 폴더에 세 실행 파일만 복사했으며 원본 해시 일치와 Pi 문법 검사를 확인했다.
* 최초 6픽셀 Pi 30초 시험 완료: 두 눈 묶음 654프레임, 평균 21.8fps, 화면 지우기 후 종료 코드 0. 실제 두 패널의 출력과 장착 정렬은 사용자 확인 대기다.
* 10픽셀 후속 변경: 문법 및 7개 단위 검사 통과, 위치/타이밍 유지와 실제 렌더링 두께 확인. 설정 파일만 Pi에 복사하고 SHA-256 일치를 확인했다. 30초 시험은 656프레임, 평균 21.9fps, 화면 지우기 후 종료 코드 0으로 완료했다. 두께에 대한 사용자 육안 평가는 대기 중이다.
* 후속 사용자 확인: 재부팅 후 10픽셀 두 눈 시험에 "응. 잘 보였고"라고 실제 출력을 확인했다. "이제부터 테스트는 15초동안만 하자" 요청에 따라 기본 시간을 15초로 변경했다. 별도 요청 없이 시간을 늘리지 않는다.
* 실행 및 치수 조정: [14_DUAL_OLED_EYES.md](14_DUAL_OLED_EYES.md). 기본 실행은 `bash ~/cuvo_oled_test/run_oled_pair_test.sh`이며 15초 후 화면을 지운다.
* 15초 기본값 반영 후 문법/7개 단위 검사 및 Pi 파일 해시 일치를 확인했다. 시간 옵션 없이 실행해 실제 15.0초, 323프레임, 평균 21.5fps, 종료 코드 0과 화면 지우기를 확인했다.
* 다음 확인: 양쪽 실물 출력, 상하 방향, 장착 상태에서 눈구멍 가림 여부. 전시 시퀀스와의 통합은 아직 하지 않았다.
* 기존 전시 코드, Arduino, 자동 실행 설정, 서보 설정은 변경하지 않았다. 프로그램 재시작, Git commit/push도 하지 않았다.

## 2026-09-22 세로형 연속선 눈 시험

* 사용자 장착 방향: 세로로 긴 방향. 도트 대신 부드럽게 이어진 선을 요청했다.
* 독립 OLED 시험의 도트 렌더링을 타원 테두리, 둥근 아치, 끝이 둥근 수평선으로 변경했다.
* 3번 패널은 `--controller sh1106 --rotate 1`로 논리 화면 64x128을 사용한다. 반대 방향 장착은 `--rotate 3`으로 맞춘다.
* 최신 사용자 요청 반영: 밝기 설정 `contrast(255)`, 좌우 여백 0, 선 두께 6픽셀. 세로형 뜬 눈은 64x108픽셀이며 위아래 여백 10픽셀은 유지한다.
* 수정 후 문법 검사 및 9개 표정/화면 크기 조합의 전체 폭, 연결성, 감은 눈 6픽셀 두께 검사를 통과했다. Pi 독립 시험 파일에 반영했다.
* 최대 밝기/전체 폭/6픽셀 설정으로 30초 시험을 종료 코드 0으로 완료하고 화면을 지웠다. 사용자가 실제 결과에 대해 "응 괜찮았어"라고 확인했으며 현재 시험 기준으로 저장하도록 요청했다.
* 1비트 흑백 화면이므로 곡선 가장자리에 픽셀 계단이 남는다.
* 재실행 진입점: Pi의 `bash ~/cuvo_oled_test/run_oled_portrait_test.sh`. Mac 원본은 `raspberry_pi/robot_demo/`에 있다. 다음 "OLED 눈 테스트" 요청에는 이 승인된 설정을 유지하고 `docs/13_OLED_EYE_TEST.md`의 재실행 절차를 따른다.
* Pi에 두 시험 파일 저장 후 SHA-256이 Mac 원본과 일치함을 확인했다. 사용자 요청으로 Pi 안전 종료 명령을 실행했다. 다음 시험 전 Pi 전원을 켜고 접속 상태를 확인해야 한다.
* Python 문법 검사 및 9개 표정/화면 크기 조합의 연결성, 여백, 중공 타원 검사를 통과했다. Pi 시험 파일에 반영 후 3번에서 30초 시험을 종료 코드 0으로 완료했다.
* 시험 후 읽기 전용 상태 확인에서 전시 `main.py` 프로세스가 보이지 않았고, 최근 로그에 Arduino `ACK,PING` 대기 시간 초과가 있었다. 원인은 미확정이며 재시작이나 서보 명령은 실행하지 않았다.
* 기존 전시 코드와 Arduino 펌웨어는 변경하지 않는다. 두 눈 및 전시 연동은 아직 미구현이다.

## 2026-09-21 현장 확인 및 OLED 작업

이 절은 아래의 이전 개발 기록보다 최신이다. 아래 배포 대기 항목은 과거 시점의 기록이다.

* 사용자 확인: LED의 빠진 선은 물리 14번 GND였으며, 16번 GPIO23과의 연결을 복구했다.
* 사용자 확인: 현재 서보와 전시 동작이 모두 정상 작동한다.
* SD카드 재장착 후 부팅과 SSH 접속이 회복됐다. 카드 전체 무결성 및 불량 원인은 미확정이다.
* CUVO 눈 추가: 실물 표시상 SH1107 128x128 SPI OLED 한 장을 연결했다.
* 독립 시험 파일 `test_oled.py`와 `docs/13_OLED_EYE_TEST.md`를 추가했다.
* Pi 별도 시험 폴더에 가상환경과 시험 파일을 준비했다. 문법 검사, 드라이버 import, 하드웨어 없는 표정 이미지 생성 검사를 통과했다.
* 사용자 SPI 활성화 후 `dtparam=spi=on`, `/dev/spidev0.0`을 확인했다. OLED 독립 시험은 뜬 눈/웃는 눈/감은 눈 두 주기(12초)를 실행하고 화면을 지운 뒤 종료 코드 0으로 완료됐다.
* 사용자 확인: 1번 OLED에 실제 표정이 보였으며 큰 문제는 없었다. 정밀한 방향/전체 픽셀 검증은 별도다.
* 3번 1.3인치 SPI 128x64 시험 준비: 상품 제목 SH1106과 상세 표 CH1116(SH1116 호환)이 불일치하므로 SH1106은 시험용 드라이버 후보이며 확정 칩명이 아니다. 교체를 위해 Pi 안전 종료 명령을 보냈다.
* 사용자 3번 배선 완료 후 `--controller sh1106`으로 12초 시험을 실행했다. 종료 코드 0이었지만 사용자는 화면이 보이지 않았다고 보고했다. 3번 출력 성공으로 판단하지 않는다.
* 같은 설정의 30초 관찰 시험 후 사용자가 3번도 실제로 표시된다고 확인했다. 최초 미관찰의 원인은 확정하지 않는다. SH1106 드라이버로 표시 가능함을 확인했으며 실제 칩명은 여전히 미확정이다.
* 사용자가 도트 디자인 수정을 위한 사진 촬영을 요청하여 같은 30초 시험을 다시 실행했다.
* 다음 작업: 사용자가 촬영한 화면을 기준으로 도트 크기, 간격과 눈 형태 조정. 두 눈 및 전시 연동은 이후 작업이다.
* 기존 전시 Python 코드, Arduino 펌웨어, 자동 실행 설정은 이번 OLED 준비에서 변경하지 않는다.

## 완료된 작업

* Mac 기준 프로젝트 구조 생성
* Raspberry Pi 실제 Python 코드 import
* WAV 파일 2개 import
* Arduino `servo_controller.ino` import
* Python 문법 검사 스크립트 작성
* Raspberry Pi 배포, 상태 확인, 로그 확인 스크립트 작성
* Arduino 원격 빌드/업로드 스크립트 작성
* `pw-play` 우선 오디오 재생 확인
* Raspberry Pi의 `/home/hyunwoo/.local/bin/arduino-cli` 존재 확인
* 공개 저장소 제외 규칙 보강
* 프로젝트 기준 문서 구조 생성
* 전시 시퀀스 고개 기본/목표 각도를 `0 -> 180 -> 0` 흐름으로 조정하고 Raspberry Pi에 배포한 이력이 있음
* 서보 회전 속도를 낮춘 설정을 Raspberry Pi에 배포함

## 현재 진행 중인 작업

* 3서보/3버튼 구조로 로컬 코드 수정
* 카메라 서보를 PCA9685 Channel 2로 추가
* 전원 OFF 버튼과 카메라 움직임 버튼 추가
* 버튼과 서보 배선 문서화
* 전시 시퀀스 로컬 기준을 고개 `0 -> 70 -> 0`, 팔 `90 -> 180 -> 90` 동시 이동으로 변경
* 카메라 버튼 로컬 기준을 `90 -> 30 -> 150 -> 90`으로 변경

## 이번 로컬 변경에서 아직 배포하지 않은 작업

* Raspberry Pi Python 코드 재배포
* Raspberry Pi 프로그램 재시작
* Arduino 컴파일 결과 확인 후 실제 업로드
* Raspberry Pi shutdown sudoers 설정 설치

## 보류 중인 작업

* GitHub push 인증 문제 해결 필요

주의: 전체 범위 고개 이동은 Arduino 안전 범위 안에 있지만 실제 기구물 충돌 위험이 있으므로 현장 확인이 필요하다.

## 다음 작업

1. 새 버튼 2개와 카메라 서보를 배선한다.
2. 카메라 서보 혼을 분리한 상태로 방향과 각도 범위를 확인한다.
3. Arduino 코드 변경은 컴파일까지만 자동 확인한다.
4. Arduino Mega 실제 업로드가 필요하면 사용자가 `Arduino 업로드 승인`이라고 명시한 뒤 진행한다.
5. Raspberry Pi 배포와 프로그램 재시작은 사용자의 별도 지시 후 진행한다.
6. 전원 OFF 버튼 사용 전 `scripts/setup_pi_shutdown_permission.sh`로 shutdown 권한을 설정한다.
7. GitHub 인증 방식 확인 후 push 재시도.
8. 전시 자동 실행 방식을 실제 Raspberry Pi OS 환경에서 검증.
9. 하드웨어 배선 사진과 핀맵 문서화.
10. 로봇 외형/기구 자료 추가.

## 위험 요소

* Arduino 업로드는 서보 움직임과 보드 reset을 유발할 수 있다.
* 고개 0도에서 180도 이동은 기구물 충돌 가능성이 있다.
* 고개 전체 범위 시험 기능은 0..180 전체 범위를 사용하므로 기구물 충돌 위험이 있다.
* 팔 180도와 카메라 30..150도는 기존보다 넓은 이동 범위이므로 기구물 충돌과 케이블 걸림 위험이 있다.
* 카메라 서보와 카메라 케이블이 고개/팔/외장 구조물에 걸릴 수 있다.
* 전원 OFF 버튼은 sudoers 설정이 없으면 종료에 실패한다.
* 자동 실행 활성화는 전원 투입 직후 예기치 않은 동작을 만들 수 있다.
* 로그, SSH 키, 토큰, `.env`, `scripts/local.env`가 공개 저장소에 포함되면 안 된다.

## 미확정 사항

* 실제 전시 배선과 전원 분배 구조
* 로봇 외형과 기구 상세
* 전체 범위 고개 이동 기능의 최종 반영 여부
* GitHub 인증 방식
* 카메라 서보 모델명과 실제 장착 방향
* 카메라 서보 30..150도 범위가 실제 기구물에서 충분하고 안전한지 여부
