d3s1gn0va/CapstonePy/docs/11_OPEN_QUESTIONS.md

# 11 Open Questions

## 제품과 전시

1. 최종 제품명 또는 전시 제목은 무엇인가?
2. 관람자가 직접 버튼을 누르는가, 전시자가 버튼을 누르는가?
3. 전시 부스에서 로봇은 어떤 높이와 방향으로 배치되는가?
4. 네트워크 없이 독립 작동할 때 전원 투입부터 시연 가능 상태까지 허용 시간은 얼마인가?

## 로봇 외형과 기구

1. 로봇의 최종 외형 이미지, CAD, 도면은 어디에 있는가?
2. 고개 SG92R과 오른팔 MG996R의 실제 장착 방향은 어떻게 되는가?
3. 카메라 서보의 모델명과 실제 장착 방향은 무엇인가?
4. 카메라 서보 30..150도 범위가 실제 기구물과 케이블에 안전한가?
5. 전원 OFF 버튼을 위해 Raspberry Pi에 shutdown sudoers 규칙을 설치해도 되는가?
3. 고개 0도와 180도 위치에서 실제 기구물 충돌이 없는가?
4. 오른팔 `70..110` 범위는 실제 기구물 기준으로 충분한가?

## 하드웨어 배선

1. Raspberry Pi, Arduino Mega, PCA9685, 서보 전원 GND가 실제로 공통 접지되어 있는가?
2. PCA9685 VCC와 V+에는 각각 어떤 전압이 들어가는가?
3. 서보 외부 전원 용량은 얼마인가?
4. 버튼 회로는 풀업/풀다운 중 어떤 실제 배선인가?
5. 안전 종료 버튼이나 전원 스위치가 있는가?

## 소프트웨어와 운영

1. 최종 자동 실행 방식은 systemd user service, system service, Desktop Autostart 중 무엇인가?
2. 현재 Raspberry Pi에서 `pw-play`가 전원 투입 후 항상 사용 가능한가?
3. GitHub push 인증 방식은 무엇으로 확정할 것인가?
4. WAV 파일 2개를 Public GitHub 저장소에 포함해도 되는가?
5. 고개 전체 범위 sweep 기능을 코드에 유지할 것인가, 별도 테스트 스크립트로 분리할 것인가?

## 위험 작업 승인

1. Arduino 업로드가 필요한 경우 승인 문구와 현장 안전 점검 절차를 어떻게 기록할 것인가?
2. 서보 안전 범위 확대 요청이 들어오면 누가 실제 기구물 충돌 여부를 확인할 것인가?
