d3s1gn0va/CapstonePy/docs/01_PRODUCT_CONCEPT.md

# 01 Product Concept

## 제공된 앱 자료의 서비스 콘셉트

2026-10-05 사용자가 제공한 `DESIGN.md`는 CUVO를 **영유아 발달검진 연계형 놀이 기반 관찰 로봇**으로 설명한다. 의료기관과 연계해 단기 대여하고 가정의 놀이 중 나타나는 모습을 후속 검진에 참고하는 서비스 콘셉트다. 실제 의료 서비스 운영, 임상 효과, 전달 시스템이 구현/검증됐다는 뜻이 아니다.

이번 전시는 관람자가 앱으로 놀이를 실행하고 예시 기록을 확인하는 체험으로 제안한다. 앱은 로봇의 개별 모터 제어판보다 놀이와 기록을 연결하는 보호자 경험을 보여준다. 구체적인 제안과 구현 범위는 [전시 및 앱 계획](17_EXHIBITION_AND_APP_PLAN.md)을 따른다.

## 제품 경험

로봇은 아이가 일상 속에서 자연스럽게 반응할 수 있는 짧은 상호작용 경험을 제공한다. 목표는 화려한 복잡 기능보다 반복 가능한 시연 흐름을 통해 사회적 의사소통 행동을 관찰할 수 있는 상황을 만드는 것이다.

## 사용자 맥락

* 대상 환경: 가정용 상호작용 경험 제안
* 전시 목표: 1차 심사용 워킹 프로토타입 시연
* 입력 방식: 전시 버튼
* 출력 방식: 고개 움직임, 오른팔 움직임, 카메라 좌우 움직임, WAV 음성 재생

## 현재 시연 메시지

코드에서 확인되는 오디오 파일명:

* `01_name_call.wav`
* `02_lets_play.wav`

파일명과 `main.py` 주석 기준으로 첫 음성은 이름을 부르는 문장, 두 번째 음성은 함께 놀자는 문장으로 구성되어 있다.

## 최종 전시 기능과 개발 시험 기능 구분

최종 전시 기능으로 확인된 흐름은 버튼 기반 시연 시퀀스다.

개발 시험 항목:

* 고개 0도에서 180도 전체 범위 이동 요청

이 전체 범위 이동은 기구물 충돌 위험이 있으므로 최종 전시 동작으로 확정하지 않는다.

## 확인 필요

* 실제 음성 대사의 최종 문구와 녹음 출처
* 대상 사용자군 정의의 발표용 문장
* CUVO의 최종 로고와 브랜드 에셋
* 로봇의 감성 키워드와 외형 디자인 언어
