d3s1gn0va/CapstonePy/docs/assets/eye_preview/aperture_right.png

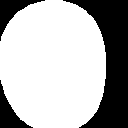
docs/assets/eye_preview/aperture_right.png
