d3s1gn0va/CapstonePy/docs/assets/eye_preview/blink.gif

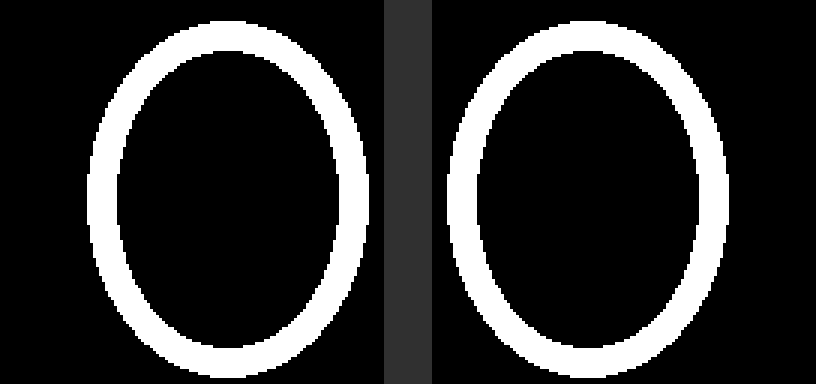
docs/assets/eye_preview/blink.gif
