d3s1gn0va/CapstonePy/docs/assets/eye_preview/closed.png

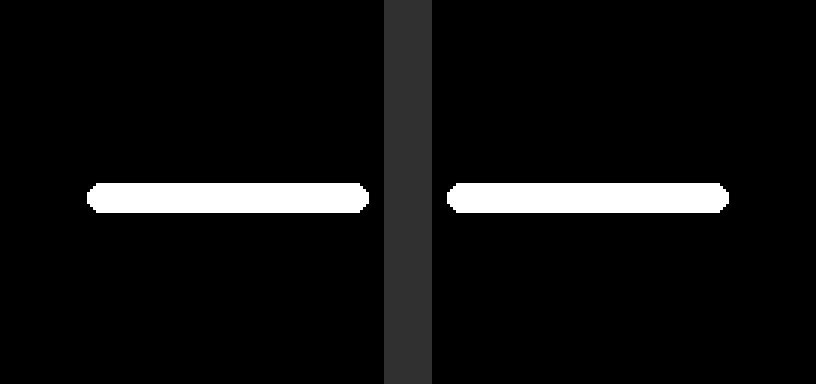
docs/assets/eye_preview/closed.png
