d3s1gn0va/CapstonePy/docs/assets/eye_preview/look_left.png

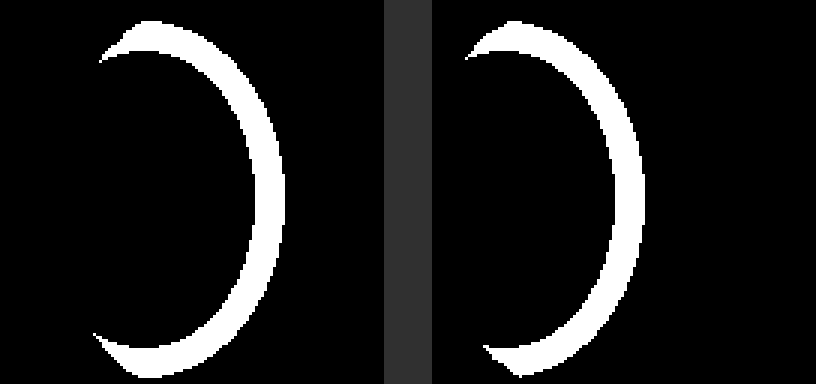
docs/assets/eye_preview/look_left.png
