d3s1gn0va/CapstonePy/docs/assets/eye_preview/look_right.png

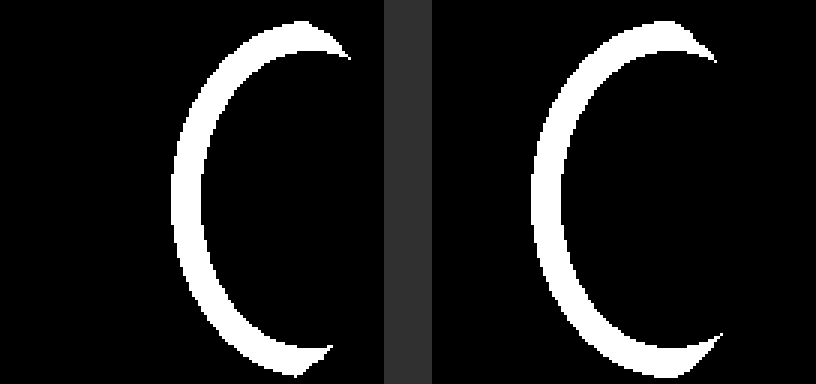
docs/assets/eye_preview/look_right.png
