d3s1gn0va/CapstonePy/docs/assets/cad_exports/eye_opening_left.dxf

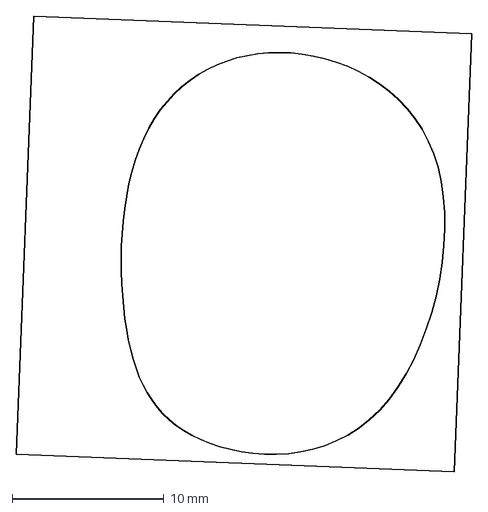
[picture p7: CAD file, 2026-10-20]
docs/assets/cad_exports/eye_opening_left.dxf
30.0 x 30.0 mm
