d3s1gn0va/CapstonePy/docs/assets/eye_preview/calibration.png

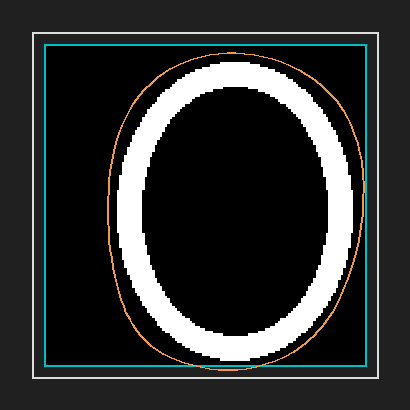
docs/assets/eye_preview/calibration.png
